robertbraeutigam/cessna172/README.md

# Cessna 172 home cockpit

A home cockpit of the Cessna 172 for the X-Plane flight simulator. The parts
are designed in [OpenSCAD](https://openscad.org/) and 3D printed, and the
controls are read by [MobiFlight](https://www.mobiflight.com/) on an
Arduino Mega (the throttle quadrant uses its own ESP32).

Each cockpit component has its own directory:

| Directory | Component |
|---|---|
| [`throttle/`](throttle) | throttle quadrant: throttle, mixture and carb heat |
| [`switchpanel/`](switchpanel) | the 172N lower left switch panel: ignition key, master, lights, avionics; the primer above it |
| [`frame/`](frame) | the aluminium frame and panel sheet that everything mounts on |
| [`hub/`](hub) | the box with the MobiFlight Mega and the Cat5 ports |

The pictures below are rendered from the current `master` by the
[Build](.github/workflows/build.yml) workflow and published, together with
all printable STLs, on the
[project page](https://robertbraeutigam.github.io/cessna172/).

## Building

The OpenSCAD binary comes from the `OPENSCAD` environment variable; the
designs use OpenSCAD 2021.01. Run `make` in a component directory:

```sh
cd switchpanel
make                       # render every .scad that changed (STLs + views)
make models                # only the STLs
make views                 # only the PNG views
make target/switches       # render a single file
make clean                 # remove target/
```

Output goes to `target/`. Views need a display (use
`OPENSCAD="xvfb-run -a openscad"` on a headless machine) and are trimmed and
combined into a montage if ImageMagick is installed.

A scad file can hold several printable parts. Marker comments on the line
that instantiates a part tell the Makefile what to render:

```openscad
box_lid(); // Make module lid                        -> target/<file>_lid.stl
//#big_pots(); // Ignore module                      -> never rendered
//exploded_view(); // Make view main 62,0,32         -> target/<file>_main.png
```

A leading `//` only hides a line from the OpenSCAD preview; the build still
renders it. `{{gitrev}}` in the source is replaced with the short git hash,
so the version is embossed into the parts.

Values and modules shared by several files of a component go into a
`*.inc.scad` file that the others `include`. It is not rendered itself, and
changing it renders the whole component again.

The printer is an Anycubic Kobra 3 V2 (255 x 255 mm bed). Large parts must
fit on it, and the files check it. Values that depend on bought parts
are marked MEASURE in the source; `assert()`s check that the derived
geometry still fits, so a wrong measurement fails the build instead of
printing a bad part.

# Cockpit frame

[`frame/`](frame): the frame on the desk that carries all components, and
the panel sheet over it.

Cockpit frame

The frame is all 2020 extrusion (one profile, M5 T-nuts everywhere) in two
parts, each built on its own and then bolted together:

- **Front part**, vertical, in front of the desk edge: a rectangle (top
  bar, bottom bar, an upright at each end) with an upright on each side of
  the yoke bay. The bottom bar lies just under the desk top, its top at
  desk height and its back against the desk edge (felt pads), so pushing
  the frame away hits a stop. One
  3 mm aluminium composite (ACM) sheet is screwed onto its front slots.
- **Desk part**, flat on the desk behind it: a ladder of a front rail, a
  rear rail and five crossbars. The front rail is cut at the yoke bay. The
  front part is bolted to the front rail with corner brackets, and a 45
  degree brace from each upright down to a crossbar stops it from rocking.
  The braces are 200 mm stock bars cut square, held by a bought 45 degree
  connector for 2020 at each end, in the obtuse angle (at the top the
  upright has 39 mm above the brace for it; a 250 mm brace would leave
  only 3 mm).

The panel is as low as the parts on it allow: the right stack sets it.
The throttle box face reaches 80 mm above the desk (it stands on the
20 mm rail, 50 mm box and a 10 mm flange), then 20 mm of sheet, the radio
panel's 84 mm front (to 172 mm), 20 mm of sheet and the top bar. The yoke
notch is 135 mm high, for a future 130 mm force feedback yoke (`ffb_h`;
the Saitek yoke is about 100 mm), and the switch panel needs 136 mm. The
build computes the height from these and rounds the uprights up to a
stock length (200 mm), so the panel top is 220 mm above the desk; it
checks that it stays under `sheet_h_max` (260 mm, the monitor).

Seen from the pilot, left to right:

- **Switch panel** (ignition + switches), low on the left.
- **Yoke bay**: the Saitek yoke stands on the desk, 20 mm out so its
  front sits on the bottom bar, its housing in a notch in the sheet. Its
  own clamps go around the bottom bar and the desk (the desk is thicker
  than the bar).
  A future force feedback yoke bolts to a crossbar in the bay instead.
- **Saitek radio panel**, with the **throttle box** under it.

The frame overhangs the desk edge by 22 mm (`frame_overhang`: a 2020 and
a 2 mm felt pad), so the sheet is 22 mm in front of the desk edge; the
front rail lies 18 mm on the desk.

**Desk clamps**: the front rail runs at least 50 mm past the sheet at each
end (`ear_len`, rounded so the rail halves are 450 and 400 mm). There a
bought screw clamp with rubber jaws clamps each
rail end onto the desk (the `clamp` view): the fixed jaw on the rail, the
spine in front of it beside the sheet, the screw jaw on the desk
underside, both jaws where the rail lies on the desk (`clamp_y`, 31 mm
from the frame front). The rail is 20 mm and the desk 28 mm, so a clamp
with a 50 mm opening and at least 33 mm reach fits; the build checks
`clamp_open`, `clamp_reach` and the jaw size. No printed part is in the
load path (printed parts creep under constant load), and two clamps about
1 m apart give well over 2 kN of grip, against 50-100 N of pulling on the
controls.

Below the desk top:

- **Apron**, under the throttle: a small rectangle hanging from the bottom
  bar, two 2020 hangers (corner brackets; the right one under the end
  upright) and a lower bar between their ends, covered by a small ACM
  sheet flush under the main sheet. It carries the **pedestal** with the
  trim wheel and the trim indicator (75 x 150 mm front), centered under
  the throttle, which stands on the lower bar like the throttle box on the
  front rail, and to its right the DIY **flaps panel** (lever pot and
  indicator servo, on hub port 5; not designed yet, so its 50 x 63 mm front
  plate and 64 mm depth are placeholders), as high as the desk allows: its
  body goes through a cut-out in the apron sheet and its plate is screwed
  onto the sheet. The cut-out (`flaps_body`, 3 mm smaller than the plate
  all round) follows the panel once it is designed.
- **Parking brake**, under the bottom bar in the yoke bay, directly below
  the yoke: a thin body (22 mm) under the desk top, two M5 into the bar's
  bottom slot, and the T-handle just in front of the bar. Released, it is
  almost flush and lies sideways; set, it is pulled out 50 mm and turned
  to point down. It has no face. Its body goes between the yoke's own desk
  clamps (`yoke_clamp_gap`).

Apart from the bottom bar and the thin parking brake, `knee_w` (460 mm)
around the yoke stays open for the legs. The pedestal and the parking
brake are future components; their sizes (`pedestal_size`, `park_size`)
reserve the space (the pedestal sets the apron height; its depth and the
parking brake are guesses), and the pedestal's hole is cut when it
exists. Their bodies must stay
below the desk underside.

The rule for every component: it brings its own front face, a hole is cut
into the sheet for it and its face is screwed onto the sheet. Heavy or
pulled components also stand on the frame: the throttle box sits on the
front rail and the crossbar under its middle (its front overhangs the
front part), its face flange is screwed onto the sheet like the switch
panel's and two M5 bolts through its floor go into the front rail.
The pedestal does the same on the apron's lower bar.
The extrusion carries the
loads, the sheet only covers the front, so cut-outs do not weaken it.
Keep at least 25 mm of sheet to the edge and 20 mm between cut-outs, and
drill the corners of a cut-out before sawing it. Holes for future
components are cut when they arrive.

All values are in `frame.inc.scad`; the layout (cut-outs, screw holes) is
computed from the component sizes, and the build prints the cut list
(`echo`). Lengths are rounded to stock lengths: the width to 100 mm
(`round_w`), the other bars to 50 mm (`round_d`). Only the apron's lower
bar (between the leg room and the pedestal, `round_cut`) is cut to an odd
length. With the current guesses the frame is 1000 x 360 mm and 220 mm
high above the desk, the sheet 1000 x 240 mm (it also covers the bottom
bar), the apron sheet
250 x 220 mm. With the ears the frame takes 1143 mm of the desk width.

| Part | 2020 bars |
|---|---|
| front part | top bar 1000, bottom bar 1000, 4 uprights 200, 2 apron hangers 200, lower bar 210 |
| desk part | front rail left 450, front rail right 400, rear rail 1000, 5 crossbars 300, 4 braces 200 (cut square) |

| File | Parts |
|---|---|
| `frame.inc.scad` | extrusion and sheet standard, component sizes, layout, checks |
| `frame.scad` | views, cut list |

**MEASURE:** the desk (`desk`, and `desk_skirt` if it has a frame or
drawer under the top at the front edge), the leg room the pilot needs
(`knee_w`), the desk clamps (`clamp_open`, `clamp_reach`, `clamp_w`,
`clamp_pad_d`), the free width between the yoke's own desk clamps
(`yoke_clamp_gap`), the Saitek yoke housing (`yoke_housing`,
guessed 283 mm wide like the radio panel and about 100 mm high; spec
sheet: 310 mm wide with the wheel), the force feedback yoke's height
(`ffb_h`), the radio panel body that goes through the sheet (`radio_body`,
from Logitech's "Construction dimensions for Flight Panels" drawing) and
the panel height the monitor allows (`sheet_h_max`).

The switch panel's two backs go through one hole, 1 mm larger than the
backs all round; drill its M3 mount holes through the panel's own holes,
with the panels in place. The primer has its own, smaller hole above the
left end of it, 1 mm larger than its square back, and its four flange
holes are drilled the same way. The same goes for the throttle box: its cut-out
is 1 mm larger than the box, open at the bottom, and its
flange holes are drilled with the box in place.

## Hardware

| Qty | Part | Use |
|-----|---|-----|
| 22 | 2020 extrusion, 6 mm slot | front part: top bar, bottom bar, 4 uprights, 2 apron hangers, lower bar; desk part: front rail left and right, rear rail, 5 crossbars, 4 braces (cut square) |
| 8 | 45 degree connector for 2020 | brace ends |
| - | corner brackets, M5 screws, M5 T-nuts | frame joints, and the front part onto the front rail |
| 2 | 3 mm ACM sheet | panel, cut to frame_w x (sheet_h + 20); the apron sheet |
| 43 | M5 button head screw + T-nut | sheets, throttle box, pedestal and parking brake |
| 2 | screw clamp with rubber jaws, 50 mm opening | rail ends onto the desk |
| 3 | felt pad | on the bottom bar's back, against the desk edge |

## Connections

- The **hub** (see [Hub](#hub)) holds the Arduino Mega with the MobiFlight
  firmware and 6 RJ45 ports. A powered USB hub next to it takes the USB
  cables (Mega, throttle ESP32, Saitek yoke, Saitek radio panel, later the
  FFB yoke), so one USB cable runs to the PC.
- Every MobiFlight component connects to its own hub port with one
  straight Cat5 patch cable, soldered straight to the component (see
  [Cables](#cables)): everything inside a component is soldered, the plug
  at the hub is the only separation point.
- There are two kinds of port (see [Port pinout](#port-pinout)): a **mux
  port** for a component with many switches (one CD74HC4067 mux), and a
  **direct port**, whose six signal wires each go to their own Mega pin,
  for servos, encoders, pots and a few switches. Only 5 V and GND are the
  same on both, so one cable carries everything a component like the
  pedestal or the flaps needs.

### MobiFlight

[MobiFlight](https://www.mobiflight.com/) is free and open source (MIT,
[GitHub](https://github.com/MobiFlight/MobiFlight-Connector)). The
MobiFlight Connector runs on the PC (**Windows only**) and talks to X-Plane
11/12 directly through its datarefs and commands (X-Plane's UDP interface,
no plugin). It also flashes the MobiFlight firmware onto the Mega over USB.

In the Connector, the Mega gets one device per thing on a port: a
*Multiplexer* per mux (its SIG pin as the data pin; S0-S3 are set once, on
the first mux, and shared by all), and a *Servo*, an *Encoder*, an *Analog
input* or a *Button* on a Mega pin. Each input (a mux channel is a button)
then sets a dataref or sends a command on press and on release, each output
(servo) follows a dataref. The configuration is a file: keep it with the
cockpit.

MobiFlight sends an X-Plane command only once; it cannot hold one while a
button is pressed (still open:
[MobiFlight-Connector#2405](https://github.com/MobiFlight/MobiFlight-Connector/issues/2405)).
Where a command has to be held, like the ignition START, a small
FlyWithLua (NG) plugin
script in X-Plane does it (see [In X-Plane](#in-x-plane)).

MobiFlight reads encoders only on their own pins, not through a mux, and
drives servos straight from Mega pins, without a second board: that is
what the direct ports are for.

### Port pinout

At the hub it is the RJ45 pin, at the component the wire color (the cable
is soldered there). Pins 4 and 5 (the blue pair) are 5 V and GND on every
port; at the hub they are soldered together across all 6 ports.

**Mux ports (1-3):**

| Pin | T568B color | Signal | At the hub |
|-----|---|---|---|
| 1 | white-orange | S0 | mux bus, Mega pin 22 |
| 2 | orange | S1 | mux bus, Mega pin 23 |
| 3 | white-green | S2 | mux bus, Mega pin 24 |
| 4 | blue | 5 V | all ports, Mega 5 V |
| 5 | white-blue | GND | all ports, Mega GND |
| 6 | green | S3 | mux bus, Mega pin 25 |
| 7 | white-brown | SIG | the port's own Mega pin (the mux output) |
| 8 | brown | AUX | the port's own Mega pin: one analog input, a button or a servo |

S0-S3 are shared by every mux (MobiFlight takes them once per board); at
the hub pins 1, 2, 3 and 6 of ports 1-3 are soldered together (the mux
bus). Every mux gets a pull-up resistor from SIG to 5 V. MobiFlight turns
on the Mega's internal pull-up, but that is weak (20-50 kOhm), and its
docs recommend an extra one for long wires: solder a 4.7 kOhm between the
SIG and VCC pins on each mux board, in the component.

**Direct ports (4-6):**

| Pin | T568B color | Signal | At the hub |
|-----|---|---|---|
| 1 | white-orange | servo 5 V, or line E | servo header 5 V, or its own Mega pin |
| 2 | orange | servo GND, or line F | servo header GND, or its own Mega pin |
| 3 | white-green | line A | its own Mega pin |
| 4 | blue | 5 V | all ports, Mega 5 V |
| 5 | white-blue | GND | all ports, Mega GND |
| 6 | green | line B | its own Mega pin |
| 7 | white-brown | line C | its own Mega pin, or the servo header (servo signal) |
| 8 | brown | line D | its own Mega pin |

Each line is whatever the component needs: a pot wiper (analog Mega
pin), an encoder contact, a switch (any digital pin) or a servo signal.
The rules:

- **A servo** takes its power on the orange pair (pin 1 5 V, pin 2 GND) and
  its signal on pin 7. At the hub they go to the servo header on the
  prototype board (see [Hub wiring](#wiring)), not to the blue pair: the
  servo's current peaks then do not move the GND and 5 V that the pots
  and the logic on the same cable use. Without a servo, pins 1 and 2 are
  two more lines.
- **Pots** go between 5 V and GND of the blue pair, the wiper on a line.
- **Switches and encoders** go to GND (pin 5) like on a mux, active low,
  with a 4.7 kOhm pull-up to 5 V at the component on each line (the same
  reason as the mux SIG pull-up).

**A wrong port does not damage anything**, it only mixes up the inputs in
the sim until the cable is in its own port again (they are numbered). Every
Mega output that goes into a cable has a 330 Ohm resistor in series at the
hub (S0-S3 and each servo signal, on the prototype board), so a component
in the wrong kind of port can not short a Mega output against a switch to
GND or a pot at its end stop. Still, mark the direct ports at the hub (a
paint pen dot next to their numbers).

### Cables

At the hub every cable has its RJ45 plug; at the component it is soldered
straight to the mux or to the parts, without a connector. Cut a patch
cable to length, or in half for two components:

- **Stranded** patch cable, not solid installation cable: solid wire breaks
  next to a solder joint after a few bends.
- **Pure copper** ("CU"), not CCA (copper clad aluminium, common in cheap
  cables): CCA hardly takes solder and breaks easily.
- **Check the colors** against the [Port pinout](#port-pinout) before
  soldering, with a multimeter or a cable tester: most patch cables are
  T568B, a few are T568A (orange and green pairs swapped).
- **Strain relief**: tie the jacket down on the component right before the
  wires fan out (the switch panel has a block for a cable tie next to the
  mux), so pulling the cable never pulls a solder joint. Tin the strands
  first and put heat shrink over every joint; cut unused wires short and
  insulate them.
- Measure the run to the hub and leave some slack: the length is fixed
  once it is soldered.

### Ports

**Mux ports**:

| Port | Component | SIG | AUX |
|---|---|-----|-----|
| 1 | yoke handle: PTT, trim switch, more buttons (FFB yoke, later) | D26 | A1 |
| 2 | free | D27 | A2 |
| 3 | switch panel | D28 | A3, primer |

**Direct ports** (pin 4 5 V and pin 5 GND on all of them):

| Port | Component | Pin 3 (A) | Pin 6 (B) | Pin 7 (C) | Pin 8 (D) | Pins 1, 2 |
|---|---|---|---|---|---|---|
| 4 | pedestal: trim wheel, trim indicator, parking brake | D30, encoder A | D31, encoder B | D2, trim servo | D32, parking brake | servo power |
| 5 | flaps: lever and indicator | A4, lever pot | D33 (free) | D3, flaps servo | D34 (free) | servo power |
| 6 | throttle quadrant (if it moves to the hub, see below) | A5, throttle | A6, mixture | A7, carb heat | A8 (free) | A9, A10 (free) |

The pins are suggestions: any free pin works (pots on analog pins), select
it in the MobiFlight Connector. A component that needs more than a port
gives gets a second port of the kind it needs.

The direct ports leave room: a Mega has 16 analog and 54 digital pins, and
MobiFlight takes at most 6 multiplexers on one (`MaxInputMultiplexer` in its
board file), of which this hub uses 3. More components than the 6 ports get
a second hub with its own Mega, on its own USB cable to the powered USB
hub; the Connector shows it as a second board. Two Megas can not drive the
same S0-S3 bus.

- **Pedestal**: one cable for everything on it. The trim wheel encoder
  (EC11 type, 20 detents) on lines A and B, its common on GND; set the
  encoder type in the Connector to match the encoder (steps per detent) and
  test that a fast spin does not lose steps. The trim indicator servo (9 g)
  on pin 7 and the orange pair.
- **Parking brake**: one switch, on line D of the pedestal port: two wires
  from the pedestal along the bottom bar to the brake under the yoke. A
  *Button* on D32 in the Connector.
- **Flaps** (DIY, on the apron next to the pedestal): the lever pot on
  line A, the indicator servo (9 g) on pin 7 and the orange pair. Two lines
  are left (e.g. a switch at the flap detents, if the lever gets one).
- **Throttle quadrant**: open. It is an ESP32 on USB today; on port 6 its
  three pots go on lines A-C, with no mux and no ESP32.
- **Likely later**: panel light dimmers (pots, on free lines), steam gauges
  (servos on a direct port, or steppers with a driver board in the hub),
  outputs (annunciator lights, avionics displays): MobiFlight drives them
  through 74HC595 shift registers or MAX7219 drivers with three lines each
  (data, clock, latch), which fit a direct port.

**Logic only** on the blue pair: the muxes, pots, encoders and hall
sensors draw a few mA. The servos take their current on their own orange
pair from the servo header in the hub, which is fed from the Mega 5 V for
now (see [Power](#power-later)); put a 470 uF capacitor across the supply
at each servo. A 9 g servo draws about 0.15-0.3 A when it moves and up to
0.7 A stalled, about 0.2 V drop on 2 m of the 24 AWG pair. Two of them on
the Mega's USB 5 V is the limit: if the Mega resets when both move at
once, feed the servo header from a 5 V supply. GND has to stay in the cable
with the signals, and the logic 5 V has to come from the Mega, so a
component is never powered while its inputs are not (or the other way
round).

### Why not a serial bus

A serial bus (I2C, UART, RS485, CAN) would need 2 signal wires instead of
the mux's 5 lines, but it does not save a cable: every component gets one
Cat5 cable either way, with 8 wires, and the S0-S3 lines are shared, so
each extra mux costs only one Mega pin. The options:

- **74HC165 input shift registers**: MobiFlight reads them (*Input Shift
  Register*, 8 inputs per chip, chained). Three lines (data, clock, latch)
  instead of the mux's five, but they also have to go to every component,
  and 8 pull-up resistors per chip: no gain over the mux.
- **I2C port expanders** (MCP23017, PCF8574): not in the standard
  MobiFlight firmware for inputs (it uses I2C only for LCD displays), and
  I2C is made for a circuit board, not for 2 m cables.
- **UART, RS485, CAN**: these need a microcontroller in every component
  and our own firmware at both ends; MobiFlight does not speak them. The
  MobiFlight way to do that is a small board per component that runs
  MobiFlight itself (e.g. an Arduino Pro Micro, on its own USB cable to the
  powered USB hub), like the throttle's ESP32: fine for one or two
  components, but each is one more board to flash and one more USB device.

### Power (later)

USB only for now. With lighting, gauges or the FFB yoke comes one 24 V PSU
with fused branches, buck converters for 5 V, a separate cut-off switch on
the FFB motor power and one star ground at the PSU. The servo header in
the hub is then fed from a 5 V converter instead of the Mega 5 V (remove
its link, see [Hub wiring](#wiring)), so the servos keep their orange pair
in the Cat5. Bigger loads (backlighting, more servos in one component) get
their current from a separate 2 wire 5 V bus with a 2 pin plug per
component (e.g. JST-VH or a 5.08 mm screw terminal), not from the Cat5;
its GND is tied to the Mega GND at one point in the hub. Leave room for
that plug in components with loads; the hub has a hole for the bus in its
back wall.

# Hub

[`hub/`](hub): the box with the MobiFlight Mega and the Cat5 ports.

Hub

`hub.scad` prints the box (`hub_box.stl`, floor down) and the lid
(`hub_lid.stl`, top down). The box is 249 x 135 x 55 mm with the lid
(one row of 6 ports, `port_cols`); the build checks that it fits the
printer bed.

From the front wall to the back:

- **Ports**: 6 RJ45 breakout boards in a row along the front wall,
  their jacks behind cut-outs in it, numbered 1-6 from the left, the
  numbers beside the jacks: 1-3 are the mux ports, 4-6 the direct ports
  (see [Port pinout](#port-pinout); mark them). The boards are screwed onto bosses on the
  floor with M2 self tapping screws from above. Their angled 8 pin headers
  point into the box. Behind them is a 30 mm strip for the jumpers, then one row of
  boards:
- **Mega** (left): on 6 standoffs, its USB jack through the left wall
  (flush with the outside, so any USB-B plug fits), with a cut-out in
  front of the power jack for later.
- **Prototype board** (next to the Mega, 20 mm away): a 50 x 70 mm board
  on four standoffs, with the bus header, the servo header (below) and
  room for small extra circuits if they are needed (later the power bus
  distribution). The hole for the power bus is in the back wall behind it.
  The rest of the row, on the right, stays free (a stepper driver board,
  later).
- The build checks the room for a plugged jumper (30 mm) above every
  board.
- The lid has a locating lip and is screwed onto four corner posts. Four
  ears on the floor (5.3 mm holes) screw the box onto the frame (M5 + T-nut)
  or under the desk.

Nothing on the Mega is soldered: it keeps its pins free and can be reused,
and a port is rewired by moving jumpers. The MobiFlight firmware is flashed
from the Connector through the Mega's USB jack in the left wall, with the
lid on.

### Hardware

| Qty | Part | Use |
|-----|---|-----|
| 1 | Arduino Mega 2560 | MobiFlight board |
| 1 | prototype board, 50 x 70 mm | bus header, servo header, extra circuits if needed |
| 2 | female header strip, 8 pin, 2.54 mm | bus header, servo header |
| 6 | 330 Ohm resistor | in series with S0-S3 and the 2 servo signals |
| 6 | RJ45 breakout board, 34 x 28 mm, angled 8 pin header | the ports |
| 18 | M2 x 6 self tapping screw | RJ45 boards |
| 4 | M2 x 6 screw | prototype board |
| 6 | M3 x 6 self tapping screw | Mega |
| 4 | M3 x 10 self tapping screw | lid |
| - | insulated wire, about 0.25 mm2, 6 colors | the bus |
| ~20 | male-female jumper wire, 20 cm | RJ45 pins to the Mega and to the servo header |
| ~10 | male-male jumper wire, 10 cm | bus and servo header to the Mega |

Per port used: a stranded copper Cat5 patch cable, soldered at the
component end (see [Cables](#cables)).

**MEASURE when they arrive**: the RJ45 boards (`rj_*`): the jack's height
and its position on the board, the header position and the mounting holes
(guessed from the listing picture; fix `rj_holes` before printing, the
build checks that the bosses stay on the board). The
prototype board's hole positions (`proto_*`; if its holes are smaller than
M2, use M1.6 screws). The Mega values are from the Arduino drawing.

### Wiring

**Bus**: one insulated wire per line, one color each, soldered along the
row of boards. Strip a short piece of insulation where it passes a pin and
solder it there, at the pin's base by the header, so it does not touch the
other pins it crosses:

- 5 V and GND (pins 4 and 5): across all 6 ports.
- S0, S1, S2, S3 (pins 1, 2, 3 and 6): across the mux ports 1-3 only.
  Ports 4-6 keep these pins for their own lines.
- To the prototype board: six wires from port 1's pins 1-6 to an 8 pin
  female header on it (the bus header): S0, S1, S2, S3, 5 V, GND, 5 V,
  GND. S0-S3 go through a 330 Ohm resistor each, soldered between the
  wire and the header pin.

**Servo header**: a second 8 pin female header on the prototype board,
for the servos of ports 4 and 5: 5 V, GND, signal in, signal out, twice.
Each signal in goes through a 330 Ohm resistor to its signal out. Its 5 V
pins are joined to the bus header 5 V by one wire link (the one to remove
when a 5 V supply feeds the servos, see [Power](#power-later)), its GND
pins to the bus header GND for good.

Everything else is a jumper:

| From | To | Jumper |
|---|----|---|
| ports 1-3 pin 7 (SIG) and pin 8 (AUX) | their Mega pins (see [Ports](#ports)) | male-female |
| ports 4-6, each pin with a line | its Mega pin | male-female |
| ports 4 and 5 pins 1, 2, 7 (servo 5 V, GND, signal) | servo header 5 V, GND, signal in | male-female |
| servo header signal out | Mega D2 (port 4), D3 (port 5) | male-male |
| bus header S0-S3 | Mega pins 22-25 | male-male |
| bus header 5 V, GND | Mega 5 V, GND | male-male |

Add a Servo device on D2 and D3 in the Connector.

### Assembly

1. Screw the RJ45 boards onto their bosses (M2 x 6).
2. Solder the bus wires along the row (S0-S3 only across ports 1-3).
3. Solder the bus header, the servo header and the resistors onto the
   prototype board and wire the bus header to port 1.
4. Screw the prototype board and the Mega onto their standoffs.
5. Plug the jumpers as above and label them.
6. Screw the lid on.

# Throttle quadrant

[`throttle/`](throttle): throttle, mixture and carb heat in one box.

Throttle quadrant

Each control is a 6 mm rod that comes out of the front of the box and moves
the slider of a linear potentiometer inside: long pots (130 mm) for the
throttle and mixture, a short one (75 mm) for the carb heat. The pots sit on
stands and are held down by printed pins. A printed clamp on each rod has a
slot that takes the pot's slider ear, so pulling the knob moves the slider.
An ESP32 on a pedestal at the back reads them and connects to the simulator
over USB.

The box mounts in the [cockpit frame](#cockpit-frame) and has no lid: it
goes through a cut-out in the panel sheet and stands on the frame's front rail. Its
front wall is the face, with a 10 mm flange on the top and the two sides
(none at the bottom, where the box sits on the rail) that is screwed onto
the sheet with M3 screws, nuts behind the sheet. Two M5 bolts through the
floor, at the front between the rod supports, go into T-nuts in the
front rail's top slot, so pulling a knob does not load the sheet alone.

| File | Parts |
|---|---|
| `throttle_box.scad` | the box with its face flange (printed in one piece), pot holder, cable cradle |
| `carb_heat_knob.scad` | carb heat knob and button |
| `clamp.scad` | rod clamps for the pot sliders |
| `pin.scad` | pot hold-down pins |

## Hardware

| Qty | Part | Use |
|-----|---|-----|
| 2 | linear potentiometer, 130 mm | throttle, mixture |
| 1 | linear potentiometer, 75 mm | carb heat |
| 3 | 6 mm rod, with nuts | one per control |
| 1 | ESP32 board | reads the pots, USB to the PC |
| - | M3 screws | pot hold-downs, cable cradle |
| 5 | M3 x 10 pan head screw + nut | face flange onto the cockpit sheet |
| 2 | M5 x 10 button head screw + washer + T-nut | floor into the front rail (counted in the frame) |

# Switch panel

[`switchpanel/`](switchpanel): the lower left switch panel of the 172N.
Similar in function to the Saitek Switch Panel, but it should look as close
to the real panel as possible. Every switch position is a raw input for
MobiFlight, active low, like a switch to GND.

It is two panels, printed separately and mounted side by side: the ignition
on the left and the switch row, which also carries the input multiplexer
for both. Their basics are in `panel.inc.scad`: both are 3 mm thick,
with the same rim, flange, mount holes and lettering. The back of each
panel is 80 mm high (`panel_h`), closed by an 8 mm rim, and goes through a
hole in the cockpit sheet ([frame](#cockpit-frame)); a 10 mm face flange
(`flange_w`) on the top, the bottom and the outer end sits on the sheet
and is screwed to it with M3 screws, nuts behind the sheet. Where the two
panels meet there is no flange and the corners are square, so together
they look like the one piece panel of the airplane (about 309 x 100 mm,
the face 3 mm in front of the sheet).

The [primer](#primer) is a third, small panel of its own above the left
end (`primer.scad`), with its own hole in the sheet. `panel.inc.scad`
takes the height of the back as a parameter for it.

## Ignition switch

Ignition switch

`ignition.scad`: the OFF - R - L - BOTH - START key switch. The key turns
clockwise; OFF, R, L and BOTH are detents, START is spring loaded and
returns to BOTH.

### How it works

It is built around a cheap mailbox (cabinet) cam lock. These locks turn
only 90°, so the lock is made to turn freely and the assembly has its own
end stops for the whole OFF..START sweep. On the lock used here the stop is
a small tab (about 1 mm) on the plug just behind the face, which runs into
two of the four grooves in the housing: take the cam, its washer and the
cam screw off, pull the plug out with the key in (the small detent ball
falls out, it is not needed), file the tab flush with the plug and put it
back; the printed rotor on the spindle then holds the plug in. The key can
be pulled every 90°, with the key parallel or perpendicular to the body
flats (`lock_key_home`), so the flats of the cutouts in the face, panel
and housing are turned to put one of these positions at OFF. It also
comes out 90° further, at BOTH.

A printed rotor on the lock's spindle sits in a housing behind the panel,
closed by a cover:

- **Detents:** a steel ball, pushed by a spring in a radial channel of the
  housing, drops into notches in the rotor rim. START has no notch.
- **End stops:** a lug on the rotor rim moves in a pocket of the housing.
- **START return:** an M3 screw through the cover is a pin in an arc slot of
  the rotor. From OFF to BOTH it moves freely in the narrow part of the
  slot. Past BOTH it pushes a printed shoe that compresses a spring in the
  wide part, and the spring pushes the key back to BOTH.
- **Sensing:** a magnet in the rotor lug and one digital hall sensor per
  position in the cover. The sensors (A3144, unipolar, not latching) are
  open collector and pull low over the magnet, so each one is wired like a
  switch to GND. They are glued into pockets on the inside of the cover,
  marked face towards the rotor, and their legs are bent 90° backwards
  through slots in the cover.
- **Sensor boards:** the wires are not soldered to the thin legs but to a
  small piece of prototype board on each sensor (3 x 4 holes, 2.54 mm
  pitch). It slips onto the legs about 5 mm behind the cover
  (`board_z`), where they have spread to 2.54 mm. A printed holder, an
  arc on the back of the cover, has a post under each board, and one M2
  screw through a hole drilled in the board's outer row holds it there.
  The hole is in the OUT leg's column (the A3144 legs are 5 V, GND, OUT
  seen on the marked face), which needs only one wire, so the 5 V and GND
  columns keep two free holes each: one for the wire in, one for the wire
  on to the next board.
  The holder's two ears go under the two cover screws on the switch panel
  side and are clamped by the cap. A 3 x 5 piece works too, with the legs
  in its second row (`board_rows = 5`, `board_leg_row = 1`).
- **Back cap:** a cap over the cover protects the boards, their solder
  joints and the wires. The 7 wires (5 signals, 5 V, GND) leave through a
  notch in its wall towards the switch panel; hot glue in the notch is the
  strain relief, so pulling the cable does not pull on the legs. The cover
  screws go through the cap as well.

Printed parts: face, panel, housing, rotor, shoe, cover, holder, cap.

The panel is 87 x 100 mm (the back 77 x 80 mm). Its front is a separate
1 mm face with the position labels, tick marks and MAGNETOS standing 0.8 mm
out of it around the key, to be painted with a white acrylic paint pen.
The face is printed front side up (the STL is already flipped), the panel
front side down, so neither needs supports; together they are 3 mm thick,
like the switch panel. The mount screws clamp the face onto the panel,
and so does the lock flange (glue or double sided tape it on
as well if it bows); it has holes around the heads of the panel screws.
The lock body goes through
a cutout with flats, so it cannot turn, and the housing sits on the back,
between the rims. The cutout is turned so the key points at OFF
(`key_off_angle`) where it comes out of the lock.

### Hardware

| Qty | Part | Use |
|-----|---|-----|
| 1 | mailbox / cabinet cam lock | key and spindle (`lock_*`: 18 mm thread, 17 mm body, 25 x 4 mm nut, 7 mm square spindle, its M4 x 5 cam screw with a 12 mm head holds the rotor) |
| 1 | 6 mm steel ball + spring | detent (`detent_spring_*`, spring OD below 6 mm) |
| 1 | spring, 5 mm OD, 15 mm | START return (`start_spring_*`) |
| 1 | cube magnet, 5 x 5 x 5 mm | position sensing (`magnet_*`) |
| 5 | A3144 hall sensor | one per position (OFF is optional) |
| 1 | prototype board, 2.54 mm pitch | 5 pieces of 3 x 4 holes, one on each sensor's legs |
| 5 | M2 x 6 screw | sensor boards onto the holder |
| 4 | M3 x 25 screw | cap and cover (M3 x 10 to test without the cap) |
| 4 | M3 x 10 screw | panel to housing |
| 1 | M3 x 8 screw | START pin |
| 4 | M3 x 10 pan head screw + nut | panel onto the cockpit sheet |

### Assembly

1. Put the lock through the panel and the housing, screw the panel to the
   housing, tighten the lock nut.
2. Mount the rotor with the lock's cam screw.
3. Insert the ball and its spring, and the shoe and its spring.
4. Check which magnet face triggers the sensors, then glue in the magnet and
   the sensors.
5. Screw on the cover (M3 x 10 screws to test), then put in the START pin.
6. Drill the outer row hole in the OUT leg's column of each board piece
   to 2.2 mm.
   Put the holder on the cover (ears over the two cover screw holes on the
   switch panel side), slip the boards onto the sensor legs and screw them
   onto the posts with the M2 screws.
7. Solder the legs to the boards and trim them. Solder the wires into the
   next row, each next to its leg, and bridge them to it: 5 V and GND
   chained from board to board, one signal wire each.
8. Lay the bundle into the cap's notch, screw on the cap with the M3 x 25
   screws (it clamps the holder's ears), and fill the notch with hot glue,
   with a blob on the inside that is bigger than the notch.

The positions (30° apart) should be verified against the real switch.

### In X-Plane

X-Plane's key is spring loaded: writing START (4) to
`sim/cockpit2/engine/actuators/ignition_key` jumps back to BOTH in the next
frame, and MobiFlight cannot hold the starter command. So START goes
through `switchpanel/ignition.lua`, a FlyWithLua script: it creates the
dataref `cessna172/ignition/start` and holds `sim/starters/engage_starter_1`
while it is 1. Copy it to `X-Plane/Resources/plugins/FlyWithLua/Scripts/`.

In the MobiFlight Connector (inputs C11..C15 of the mux):

| Input | On press | On release |
|---|---|---|
| OFF, R, L, BOTH | `sim/cockpit2/engine/actuators/ignition_key[0]` = the position | nothing |
| START | `cessna172/ignition/start` = 1 | `cessna172/ignition/start` = 0 |

Releasing START springs the key back to BOTH, whose sensor sets the key
position again. **VERIFY** the key values (0 is OFF, 3 is BOTH; check
which of 1 and 2 is L) with DataRefTool while turning the key in the
virtual cockpit. Start X-Plane (or reload the Lua scripts) before
connecting MobiFlight, the START dataref only exists once the script has
run. If MobiFlight disconnects in START, the starter keeps cranking until
the key is turned in the cockpit or the scripts are reloaded.

## Primer

Primer

`primer.scad`: the push-pull primer with its twist lock, read by a linear
pot. It is a separate 47 x 47 mm panel above the left end of the switch
panels, flush with their left edge, in its own cut-out in the sheet, so
the ignition panel stays as it is. The knob pulls out 45 mm (`stroke`,
about the 1¾" of a panel plunger primer) and pushes back in; fully in, it
turns a quarter turn clockwise to lock, and only then. Turned back
(counterclockwise), a spring pops it 5 mm out (`pop`), like the real one.

### How it works

The same idea as the [throttle quadrant](#throttle-quadrant): a 6 mm rod
moves the slider of a linear pot, through a clamp-like carrier with a slot
over the pot's slider ear. The pot is the 75 mm one used for the carb heat.

- **Knob and twist lock:** the knob's 10 mm stem slides in a square tube on
  the back of the panel, the front bearing. A lug on the end of the stem
  runs in a keyway along the tube, so the knob cannot turn while it is out
  and always comes back lined up. At the back of the tube the keyway opens
  into a quarter turn pocket: fully in, the lug turns into it and the end of
  the keyway holds it (locked). Pulled out, the lug stops on the back of
  the panel plate.
- **Rod:** an M3 set screw in the knob's head holds the rod. The rod runs
  back through the bracket, whose front wall (screwed onto the end of the
  tube) and rear wall are two more bearings.
- **Pot:** in the bracket the pot sits on two stands, held down by two
  printed straps, with its slider ear pointing at the rod. The carrier on
  the rod is held between two rod collars (the throttle's plain clamp). The
  rod turns in it for the twist lock; the carrier itself slides between the
  bracket's two ribs, so it cannot turn.
- **Pop out:** a compression spring on the rod, between the rear collar and
  the rear wall. The collar only reaches it in the last 5 mm before the knob
  is in, so the locked lug holds it compressed, and unlocking pops the knob
  out that far; the rest of the stroke is free.

The bracket is beside the rod towards the pilot's right, about 41 x 26 mm
across, and with the knob in, the rod ends about 193 mm behind the panel,
over the switch panel and clear of the frame's upright and brace. The
bracket is wider than the cut-out, so it goes on from behind the sheet.

### Hardware

| Qty | Part | Use |
|-----|---|-----|
| 1 | linear potentiometer, 75 mm (like the carb heat one) | primer position |
| 1 | 6 mm rod, 208 mm (`rod_len`) | knob to the pot carrier |
| 1 | compression spring, about 9 mm OD, 6.8 mm ID, 15 mm long (`pop_spring_*`) | pops the knob out when unlocked |
| 2 | `throttle/clamp.scad` plain clamp (`clamp_plain.stl`), with an M3 screw + nut | rod collars on both sides of the carrier |
| 4 | M3 x 12 socket head screw | bracket onto the tube |
| 4 | M3 x 10 screw | pot straps onto the stands |
| 1 | M3 x 6 set screw | knob onto the rod |
| 4 | M3 x 10 pan head screw + nut | face flange onto the sheet |
| - | 3 wires | pot to the switch panel's mux board |

Printed: `primer_panel.stl` (front side down), `primer_face.stl` (front
side up), `primer_knob.stl` (on the end of its stem), `primer_bracket.stl`
(on its spine), `primer_strap.stl` (2x), `primer_carrier.stl`.

The pot's travel (`pot_travel`) is measured: 60 mm, so the 45 mm stroke
uses the middle three quarters of it (the build fails if the stroke comes
within 4 mm of the travel). **MEASURE:** the pot's slider ear (`pot_ear`)
and the spring you pick (`pop_spring_od`, `_id`, `_len`, `_solid`): it
has to fit over the rod and on the collar, and it must not go solid
before the knob is in; the bracket gets longer for a longer spring. A
stiffer spring pops harder, the pot slider's friction works against it.

### Assembly

1. Paint the label, put the face on the panel, push the panel through its
   cut-out and screw the flange onto the sheet.
2. From behind: put the knob's stem into the tube, the lug in the keyway.
3. Screw the bracket onto the end of the tube (hex key through the holes
   in its rear wall).
4. Solder three wires to the pot, put it onto its stands and screw the
   straps on.
5. Push the rod in from the back: through the rear wall, the spring, a collar, the
   carrier (its slot over the pot's ear), the other collar, the front wall
   and into the knob, and tighten the set screw.
6. With the knob out, slide the carrier to where the ear is 22.5 mm
   (`stroke / 2`) in front of the pot's middle, and tighten the collars
   against it so the rod still turns.

### Wiring and X-Plane

The pot connects to the switch panel's mux board: its ends to 5 V and GND
there, the wiper to the brown AUX wire of the Cat5 cable, which goes to
the Mega's A3 at the hub (port 3, see [Ports](#ports)). It is an analog
input, not a mux input. Which end goes to 5 V decides the direction; swap
them, or invert the range in the MobiFlight Connector.

In the MobiFlight Connector it is an analog input on A3 that writes the
primer's dataref. **VERIFY** which dataref the X-Plane 172 uses for the
primer with DataRefTool while working the primer in the virtual cockpit.

## Switches

Switch panel

`switches.scad`: the switch row. The red split MASTER (ALT, BAT) on the
left, toggle switches in the middle (FUEL PUMP, BEACON, LAND, TAXI, NAV,
STROBE, PITOT HEAT) and the split AVIONICS (BUS 1, BUS 2) on the right.
Up is ON, like in the airplane. Above the toggles is a
row of circuit breakers, like on the real panel; they are for show only.

The switch list (`groups` in the source) drives the layout; it follows the
X-Plane 172 SP. For a 172N remove FUEL PUMP and the panel gets shorter. The
panel is 221.6 x 100 mm (the back 211.6 x 80 mm). Like the ignition, its
front is a separate 1 mm face with the labels standing 0.8 mm out of it,
for a white paint pen; the face is printed front side up
(`switches_face.stl`), the panel front side down, so neither needs
supports, and together they are 3 mm thick. The toggle nuts, the rocker
lips and the mount screws clamp the face on. The switches and labels need about 68 mm of the back's height, the
rest is split between above and below them. The rim on the back stiffens
it.

### Hardware

| Qty | Part | Use |
|-----|---|-----|
| 1 | double rocker switch, 6 pin, red | MASTER: ALT, BAT |
| 1 | double rocker switch, 6 pin, black (there is no white one) | AVIONICS: BUS 1, BUS 2 |
| 7 | toggle switch, M12 neck, 18 mm lever | FUEL PUMP, BEACON, LAND, TAXI, NAV, STROBE, PITOT HEAT |
| 6 | M3 x 10 pan head screw + nut | panel onto the cockpit sheet (`mount_count`) |
| 1 | CD74HC4067 16 channel mux breakout board | all inputs, see [Multiplexer](#multiplexer) |
| 2 | M2 x 6 screw | mux onto its standoffs |
| 7 | printed dummy breaker (`switches_breakers.stl`) + glue | circuit breakers, see [Circuit breakers](#circuit-breakers) |
| 1 | 4.7 kOhm resistor | SIG pull-up on the mux |
| 1 | Cat5 patch cable, stranded copper (see [Cables](#cables)) | to hub port 3, soldered to the mux |
| 1 | cable tie, up to 3.6 mm wide | the cable onto its block (`tie`) |
| - | wire, heat shrink | see [Wiring](#wiring) |

### Double rocker switches

[Double Rocker Switch 6-Pin 250V 16A/AC Red Rocker Illuminated On/Off](https://www.amazon.de/-/en/Double-Rocker-Switch-6-Pin-Illuminated/dp/B0DLTMGKSS),
in red for MASTER and black for AVIONICS. Two independent rockers side by
side in one housing, tall and narrow like the real split switches.

They snap into a cutout from the front: ramps on their top and bottom end
catch behind the face and the panel, which is thinned there by a pocket
in the back, to 0.5 mm behind the 1 mm face.
Dimensions from the listing (`rk_*`):

- panel cutout 22 x 28.5 mm (width x height)
- front lip 24.3 x 31.3 mm, 2 mm thick
- body 21.7 x 25.3 mm, no mounting holes
- 31.5 mm from the front to the end of the pins

**MEASURE when they arrive:** the gap between the lip and the ramps, i.e.
the panel thickness they snap onto (`rk_grip`, now 1.5 mm). Also check the
pin positions.

The lamps are neon (250 V) and will not light on 5 V; leave the lamp pin
unconnected. Each rocker has 3 pins: find the two that close when the
rocker is ON with a multimeter.

### Toggle switches

Standard M12 toggle switches, about the size of the real ones. From the
listing: body 30 x 15.5 x 15 mm, 12 mm neck (M12 thread), 18 mm lever.
Either a 2 pin ON-OFF or a 6 pin ON-ON (DPDT) switch works. Do not take an
ON-OFF-ON one (e.g. "-203"): the real switch has no center position.

The toggles go in from the back, and a nut and washer on the front clamp
them. The body sits in a 1 mm deep square pocket in the back of the panel,
so it cannot turn.

**MEASURE when they arrive** (`tg_*`, `toggle = "M12"`):

- The 30 mm is assumed to be from the top of the body to the end of the
  lugs, and 15.5 x 15 mm the body.
- The thread length (now 9.5 mm; the panel is 2 mm thick there, the washer
  and nut need about 4 mm of it).
- The nut across flats (now 14 mm). The switches are 19 mm apart, so a nut
  up to about 15 mm fits; the build checks this.
- The lever and the lug positions.

The mini MTS-202 (M6, 10 mm lever) works too: set `toggle = "MTS-202"`.
amazon.de listings:
[ETOPARS, 10 pieces](https://www.amazon.de/ETOPARS-Kippschalter-Armaturenbrett-Wippschalter-L%C3%B6tanschluss/dp/B08Z7R4RB9),
[Taiss, 10 pieces](https://www.amazon.de/MTS-202-Terminals-Positionen-Kippschalter-wasserdichte/dp/B07JNV6SCJ).

### Circuit breakers

The real 172N has a row of push-to-reset circuit breakers above the
switches, each with its name on the panel above it and its rating (A) on
the button. Here they are non-functional dummies: a hex nut with a button
on top and the rating engraved into the button, all printed as one part
(`switches_breakers.stl`, nut side down). They are glued into hex holes in
the 1 mm face, onto the panel behind it, which locate them and keep them
straight; nothing goes through the panel. Print them in black and paint the
nut silver and the rating white, or print the nut and the button in
different colors.

The list (`breakers` in the source, name and rating) is placed over the
toggles, one above each, from the left; the build checks that the row
still fits the panel height, and the top middle mount screw moves between
two breakers. Real breakers
(e.g. Klixon push-to-reset) would need a bigger hole and room behind the
panel, so making them functional later means a hole through the panel
as well.

### Multiplexer

All switches and the ignition go to one CD74HC4067 breakout board on the
back of the switch panel. MobiFlight reads it as a Multiplexer device: 16
inputs through one Mega pin. So everything is soldered on the panels, and
only one Cat5 cable runs to the hub (port 3).

The board sits on two standoffs in the strip behind the group labels, on
the left (pilot side) half, where the ignition cable comes in. Mount it with
the chip outwards, so the solder joints face you; `assert`s check that it
clears the switches and fits inside the rim.

**MEASURE when it arrives** (`mux_*`): the board is 40 x 18 mm in the
listings (one says 41 x 18.7 mm). The mounting holes (`mux_holes`, guessed
on the center line 17.5 mm from the middle) and the order of the control
pins (`mux_ctl_names`) are guesses. If the board turns out bigger the build
fails; then increase `margin_top`. If it has no mounting holes, glue it onto
the standoffs.

#### Inputs

| Mux | Input | Mux | Input |
|-----|---|-----|---|
| C0 | MASTER ALT | C8 | PITOT HEAT |
| C1 | MASTER BAT | C9 | AVIONICS BUS 1 |
| C2 | FUEL PUMP | C10 | AVIONICS BUS 2 |
| C3 | BEACON | C11 | ignition OFF |
| C4 | LAND | C12 | ignition R |
| C5 | TAXI | C13 | ignition L |
| C6 | NAV | C14 | ignition BOTH |
| C7 | STROBE | C15 | ignition START |

That is all 16. The switches are in label order (the `groups` order), and
the ignition positions are consecutive. In the MobiFlight Connector every
channel is a button: a toggle or rocker sets its dataref to 1 on press and
to 0 on release, an ignition position sets the key position on press, and
START holds the starter while it is pressed through a FlyWithLua script
(see [In X-Plane](#in-x-plane)). Without FUEL PUMP (172N) or
the OFF hall sensor, one input stays free.

#### Cable to the hub

The mux goes to hub port 3 (see [Port pinout](#port-pinout)) with a Cat5
cable soldered straight into its control row (see [Cables](#cables)):

| Mux pin | Wire (T568B) | Mega (at the hub) |
|---|---|---|
| S0, S1, S2, S3 | white-orange, orange, white-green, green | pins 22, 23, 24, 25 (shared by all muxes) |
| VCC | blue | 5 V |
| GND | white-blue | GND |
| SIG | white-brown | D28, the mux's data pin in the MobiFlight Connector |
| EN | - | not to the hub: bridge it to GND on the board (enable is active low) |

The brown wire (AUX) is the [primer](#primer) pot's wiper; the pot's
other two wires go to VCC and GND on the board. The cable
comes in over the top rim and is tied down with a cable tie on the block
right of the mux (`tie_block`: the tie goes through the slot at the panel
and around the cable in the groove on top), so the wires fan out from
there to the pins without any pull on them. **MEASURE** the cable
(`cable_d`, 6 mm) and the tie (`tie`, 3.6 x 1.3 mm).

The switches and the hall sensors have no pull-up resistors of their own:
one 4.7 kOhm resistor from SIG to VCC on the mux board pulls whichever
input is selected up (see [Port pinout](#port-pinout)). Test it on
the bench with one switch on the mux before soldering all of them.

### Wiring

Every input is wired like a switch to GND (active low, as MobiFlight expects):

- **Toggle, 2 pin:** one lug to GND, the other to its mux input. Mount it so
  it is ON with the lever up.
- **Toggle, 6 pin:** use one pole. Its middle lug (common) goes to GND, the
  bottom lug to the mux input: lever up (ON) connects the common to the
  bottom lug. Check with a multimeter.
- **Rocker:** the two pins of each rocker that close when it is ON; one to
  GND, the other to the mux input.
- **Ignition:** the A3144 outputs go to C11..C15. The sensors also need 5 V
  and GND: take them from the mux VCC and GND.
- **Primer:** the pot's ends to the mux VCC and GND, its wiper to the Cat5
  cable's brown AUX wire (not to the mux).

So on the switch panel: one GND wire daisy chained over all 11 switches to
the mux GND, and one signal wire from each switch to its C pin, soldered
straight into the board. The ignition cable (5 signals, 5 V, GND) is best
plugged in with a 7 pin Dupont or JST connector, so the two panels can be
separated. GND and VCC get several wires (switch chain, EN bridge,
ignition, primer, Cat5 cable): join the extra wires into one before the pin, with
solder and heat shrink.

### Assembly

1. Solder the wires to the switches first; the rockers are hard to get out
   again once snapped in.
2. Lay the face on the front, put the toggles in from the back and
   tighten their nuts.
3. Snap the rockers in from the front.
4. Solder the other wire ends to the mux and screw it onto its standoffs.
5. Solder the Cat5 cable to the mux control row and tie it onto its
   block.
6. Glue the dummy breakers into their pockets.
7. Mount the panel.

### Notes

- ALT and BAT are two independent switches. The real split master has an
  interlock (ALT pushes BAT on, BAT pushes ALT off); X-Plane does not need
  it.
