robertbraeutigam/cessna172/frame/frame.scad

// Cockpit frame
//
// Two parts of 2020 extrusion: the front part (a vertical rectangle with
// the uprights, in front of the desk edge, and the apron hanging under the
// throttle) and the desk part (a ladder on the desk, cut at the yoke),
// bolted together and braced at 45 degrees; one ACM sheet over the front
// with a cut-out for every component. Values, layout and checks are in
// frame.inc.scad; this file has the views and the cut list (echo). It has
// no printed parts.
//
// Bought parts (lengths: see the echo of the build, or the README):
// - 2020 extrusion, front part: top bar, bottom bar, 4 uprights,
//   2 apron hangers, lower bar
// - 2020 extrusion, desk part: front rail left, front rail right, rear
//   rail, 5 crossbars, 4 braces (cut square)
// - 8 45 degree connectors for 2020, one at each brace end
// - corner brackets, M5 screws and T-nuts (6 mm slot)
// - 3 mm ACM sheet, frame_w x (sheet_h + ext), and the apron sheet
// - 2 screw clamps with rubber jaws, at least ext + desk.z opening
//   (clamp_open, clamp_reach), to clamp the rail ends onto the desk
// - felt pads on the bottom bar's back, against the desk edge
//
// Assembly:
// 1. Front part, flat on the floor: the bottom bar, the uprights on it,
//    the top bar on them, the two hangers under the bottom bar and the lower
//    bar between their ends, all with corner brackets.
// 2. Cut the sheets (cuts, sheet_screws, apron_screws in the echo, the
//    "sheet" view), drill their screw holes, and screw them onto the front
//    slots with T-nuts.
// 3. Desk part: the front rail halves, the rear rail and the crossbars.
// 4. Put the desk part on the desk, stand the front part in front of the
//    desk edge, its bottom bar against the edge (felt pads), and bolt it
//    on: a corner bracket from each upright's back to the front rail, the
//    braces from the uprights to the crossbars with a 45 degree connector
//    on each end, in the obtuse angle. Clamp each rail end (ear) onto
//    the desk with a screw clamp. Put the yoke into the bay, its front on the bottom bar, and
//    clamp it with its own clamps.
// 5. Push the throttle box through its cut-out onto the rail and the
//    middle crossbar until its face is on the sheet, bolt its floor into
//    the rail (throttle_bolts), drill the sheet through
//    its flange holes and screw the flange on (M3, nuts behind the sheet).
//    The pedestal goes in the same way onto the lower bar, the parking
//    brake under the bottom bar, when they exist.

include <frame.inc.scad>

$fn = 40;

// --- View colors ---
c_alu = "#c3c9d0";
c_sheet = "#4a4f57";
c_desk = "#c8a77a";
c_device = "#2b2e33";
c_display = "#c0392b";
c_box = "#5b6f8a";
c_switch = "#3a3d42";

echo(frame = [frame_w, frame_d, sheet_h]);
echo(front_part_2020 = [["top bar", frame_w], ["bottom bar", frame_w], ["4 uprights", upright_len],
                        ["2 hangers", hanger_len],
                        ["lower bar", apron_bar_len]]);
echo(desk_part_2020 = [["front rail left", rails[0][1] - rails[0][0]], ["front rail right", rails[1][1] - rails[1][0]],
                       ["rear rail", frame_w], ["5 crossbars", crossbar_len], ["4 braces, cut square", brace_len]]);
echo(sheet = [frame_w, sheet_h + ext], screws = len(sheet_screws));
echo(switch_cut = switch_cut, bay_cut = bay_cut, throttle_cut = throttle_cut, radio_cut = radio_cut,
     primer_cut = primer_cut);
echo(sheet_screws = sheet_screws, throttle_bolts = throttle_bolts);
echo(apron_sheet = [apron[1] - apron[0], apron_h - ext], apron_screws = len(apron_screws));
echo(pedestal_cut = pedestal_cut, pedestal_bolts = pedestal_bolts, flaps_cut = flaps_cut);
echo(m5 = len(sheet_screws) + len(apron_screws) + 2 + 2 + 2, desk_clamps = len(clamp_xs), clamp_y = clamp_y);

// --- Frame ---

module bar(p0, size) {
   color(c_alu) translate(p0) cube(size);
}

// 45 degree brace behind the upright at x, cut square: its inner edge
// from the upright's back at brace_top down to the crossbar top, and a 45
// degree connector in the obtuse angle at each end (drawn on its +x side)
module brace(x) {
   a = [ext, brace_top];
   d = [1, -1] / sqrt(2);       // along the brace (y, z)
   o = [1, 1] / sqrt(2);        // away from the corner
   multmatrix([[1, 0, 0, x], [0, d.x, o.x, a.x], [0, d.y, o.y, a.y], [0, 0, 0, 1]])
      color(c_alu) cube([ext, brace_len, ext]);
   // connectors (view only): one leg on the brace, one on the upright / crossbar
   color("#5a6068") translate([x + ext, 0, 0]) rotate([0, 90, 0]) linear_extrude(3)
      for (e = [[a, [0, 1], d], [a + brace_len * d, [1, 0], -d]])
         hull() {
            translate([-(e[0].y + 2), e[0].x + 2]) square(1);
            translate([-(e[0].y + 2 + 30 * e[1].y), e[0].x + 2 + 30 * e[1].x]) square(1);
            translate([-(e[0].y + 2 + 30 * e[2].y), e[0].x + 2 + 30 * e[2].x]) square(1);
         }
}

module front_part() {
   bar([0, 0, sheet_h - ext], [frame_w, ext, ext]);
   bar([0, 0, -ext], [frame_w, ext, ext]);
   for (x = upright_xs)
      bar([x, 0, 0], [ext, ext, upright_len]);
   // apron
   for (x = hangers)
      bar([x, 0, -ext - hanger_len], [ext, ext, hanger_len]);
   bar([apron_bar[0], 0, -apron_h], [apron_bar_len, ext, ext]);
}

module desk_frame_part() {
   for (r = rails)
      bar([r[0], ext, 0], [r[1] - r[0], ext, ext]);
   bar([0, rear_y, 0], [frame_w, ext, ext]);
   for (x = crossbar_xs)
      bar([x, 2 * ext, 0], [ext, crossbar_len, ext]);
   for (x = upright_xs)
      brace(x);
}

module frame_part() {
   front_part();
   desk_frame_part();
}

// Bought screw clamp, view only: the fixed jaw on the rail end, the spine
// in front of the rail, the screw jaw on the desk underside
module desk_clamp_part(x) {
   bar_w = 12;                                // the clamp's bars, across (x) and thick
   spine_y = clamp_y - clamp_reach;           // spine inner face
   top = ext + 3;                             // over the rubber jaw
   low = ext + 3 - clamp_open - 12;        // bottom bar top, the opening left as screw travel
   translate([x, 0, 0]) {
      color("#5a6068") {
         translate([-bar_w / 2, spine_y - bar_w, low - bar_w]) cube([bar_w, bar_w, top + bar_w - low + bar_w]);
         translate([-bar_w / 2, spine_y - bar_w, top]) cube([bar_w, clamp_reach + bar_w + clamp_pad_d / 2, bar_w]);
         translate([-bar_w / 2, spine_y - bar_w, low - bar_w]) cube([bar_w, clamp_reach + bar_w + 8, bar_w]);
      }
      color("#b9c0c8") translate([0, clamp_y, low - bar_w - 25]) {
         cylinder(d = 8, h = -desk.z - 6 - (low - bar_w - 25));
         translate([0, 0, 6]) rotate([0, 90, 0]) cylinder(d = 7, h = clamp_w + 15, center = true);
         translate([0, 0, -desk.z - 6 - (low - bar_w - 25)]) cylinder(d = clamp_pad_d, h = 3);
      }
      color("#222") translate([0, clamp_y, 0]) {
         translate([0, 0, ext]) cylinder(d = clamp_pad_d, h = 3);
         translate([0, 0, -desk.z - 3]) cylinder(d = clamp_pad_d, h = 3);
      }
   }
}

module clamps_part() {
   for (x = clamp_xs) desk_clamp_part(x);
}

// --- Sheet, x / z on the sheet ---

module rect(r) {
   translate([r[0], r[1]]) square([r[2] - r[0], r[3] - r[1]]);
}

module sheet_2d() {
   difference() {
      translate([0, -ext]) square([frame_w, sheet_h + ext]);
      for (c = cuts) rect(c);
      for (p = sheet_screws)
         translate(p) circle(d = m5_d);
   }
}

// apron sheet, x / z on the sheet (z < 0)
module apron_2d() {
   difference() {
      translate([apron[0], -apron_h]) square([apron[1] - apron[0], apron_h - ext]);
      rect(pedestal_cut);
      rect(flaps_cut);
      for (p = apron_screws)
         translate(p) circle(d = m5_d);
   }
}

module sheet_part() {
   color(c_sheet)
      rotate([90, 0, 0])
         linear_extrude(sheet_t) {
            sheet_2d();
            apron_2d();
         }
}

// --- Components, view only ---

module desk_part() {
   color(c_desk)
      translate([-100, frame_overhang, -desk.z])
         cube([frame_w + 200, desk.y, desk.z]);
}

module yoke_part() {
   x = (x_bay0 + x_bay1) / 2;
   color(c_device) {
      translate([x - yoke_housing.x / 2, yoke_front_y, 0])
         cube(yoke_housing);
      translate([x, yoke_front_y + 1, yoke_shaft_z])
         rotate([90, 0, 0]) cylinder(d = 22, h = 90);
      translate([x, yoke_front_y - 100, yoke_shaft_z]) {
         cube([yoke_wheel_w - 80, 24, 26], center = true);
         for (s = [-1, 1])
            translate([s * (yoke_wheel_w / 2 - 20), 0, 0])
               rotate([0, s * 15, 0]) cylinder(d = 32, h = 110, center = true);
      }
   }
}

module radio_part() {
   translate([x_rc, -sheet_t, radio_front_z0]) {
      color(c_device) {
         translate([-radio_front.x / 2, -radio_front_t, 0])
            cube([radio_front.x, radio_front_t, radio_front.y]);
         translate([-radio_body.x / 2, 0, (radio_front.y - radio_body.y) / 2])
            cube([radio_body.x, radio_depth, radio_body.y]);
      }
      color(c_display)
         for (sx = [-1, 1], z = [0.3, 0.7])
            translate([sx * radio_front.x / 4 - 45, -radio_front_t - 0.5, z * radio_front.y - 6])
               cube([90, 1, 12]);
   }
}

module switch_panel_part() {
   f = switch_flange;
   y_face = -sheet_t - 3;           // panel_t, the face on the sheet
   z_back = switch_z + f;
   color(c_sheet) {
      translate([x_sw0, y_face, switch_z])
         cube([f + switch_ign_w - 0.3, 3, switch_panel.y]);
      translate([x_sw0 + f + switch_ign_w, y_face, switch_z])
         cube([switch_panel.x - f - switch_ign_w, 3, switch_panel.y]);
      // rims, through the sheet
      for (p = [[x_sw0 + f, switch_ign_w - 0.3], [x_sw0 + f + switch_ign_w, switch_back.x - switch_ign_w]])
         difference() {
            translate([p[0], y_face + 3, z_back]) cube([p[1], 8, switch_back.y]);
            translate([p[0] + 2.5, y_face, z_back + 2.5]) cube([p[1] - 5, 20, switch_back.y - 5]);
         }
   }
   color(c_switch)
      translate([switch_cut[0] + 4, 5, switch_cut[1] + 4])
         cube([switch_cut[2] - switch_cut[0] - 8, switch_depth, switch_cut[3] - switch_cut[1] - 8]);
   // key, rockers and toggles on the face
   color("#b9c0c8") translate([x_sw0 + f + 38.5, y_face, z_back + 40]) rotate([90, 0, 0]) cylinder(d = 24, h = 4);
   color("#c0392b") translate([x_sw0 + f + 92, y_face - 4, z_back + 22]) cube([24, 4, 31]);
   color("#222") translate([x_sw1 - f - 32, y_face - 4, z_back + 22]) cube([24, 4, 31]);
   for (i = [0 : 6])
      color("#d0d4da") translate([x_sw0 + f + 132 + i * 18, y_face, z_back + 36])
         rotate([90, 0, 0]) cylinder(d = 4, h = 18);
}

// Primer: face, tube through the sheet, bracket behind it, knob
module primer_part() {
   y_face = -sheet_t - 3;           // panel_t
   color(c_sheet)
      translate([primer_face_r[0], y_face, primer_face_r[1]]) cube([primer_face, 3, primer_face]);
   color("#3d7bd9") {
      translate([primer_x - 11, y_face + 3, primer_z - 11]) cube([22, primer_tube, 22]);
      translate([primer_x - 11, y_face + 3 + primer_tube, primer_z - primer_bracket.y / 2])
         cube([11 + primer_bracket.x, primer_bracket.z, primer_bracket.y]);
   }
   color("#b9c0c8")
      translate([primer_x, y_face + 3 + primer_tube, primer_z]) rotate([-90, 0, 0]) cylinder(d = 6, h = primer_depth - primer_tube);
   color("#1d1f22")
      translate([primer_x, y_face, primer_z]) rotate([90, 0, 0]) cylinder(d = 22, h = 14);
}

module throttle_part() {
   r = 10;
   f = throttle_flange;
   translate([throttle_x0, throttle_y0, ext]) {
      color(c_box) {
         difference() {
            hull()
               for (x = [r, throttle_size.x - r], y = [r, throttle_size.y - r])
                  translate([x, y, 0]) cylinder(r = r, h = throttle_size.z);
            translate([3, 3, 3]) cube(throttle_size - [6, 6, 0]);
         }
         translate([-f, 0, 0]) cube([throttle_size.x + 2 * f, throttle_face_t, throttle_size.z + f]);
      }
      color("#b9c0c8")
         for (x = throttle_bolt_xs)
            translate([x, throttle_bolt_y, 3]) cylinder(d = m5_head_d, h = 3);
      for (i = [0 : 2])
         translate([throttle_rod_xs[i], 0, throttle_rod_z]) {
            color("#b9c0c8") rotate([90, 0, 0]) cylinder(d = 6, h = 60);
            color(["#9aa0a8", "#222", "#c0392b"][i])
               translate([0, -60, 0]) rotate([90, 0, 0]) cylinder(d = 26, h = 14);
         }
   }
}

// Under-desk component on its lower bar: box, face with flange, floor bolts
module under_box(x, size) {
   f = under_flange;
   translate([x - size.x / 2, under_y0, apron_bar_z]) {
      color(c_box) {
         difference() {
            cube(size);
            translate([3, 3, 3]) cube(size - [6, 6, 0]);
         }
         translate([-f, 0, 0]) cube([size.x + 2 * f, under_face_t, size.z + f]);
      }
      color("#b9c0c8")
         for (s = [-1, 1])
            translate([size.x / 2 + s * size.x / 4, under_bolt_y, 3]) cylinder(d = m5_head_d, h = 3);
   }
}

module pedestal_part() {
   under_box(pedestal_x, pedestal_size);
   // trim wheel rim out of a slot in the face, trim indicator slot below it
   z = apron_bar_z + pedestal_size.z;
   color("#222")
      translate([pedestal_x - 6, under_y0 + 40, z - 55])
         rotate([0, 90, 0]) cylinder(d = 100, h = 12);
   color("#ddd")
      translate([pedestal_x - 4, under_y0 - 0.5, apron_bar_z + 12]) cube([8, 1, 28]);
}

// DIY flaps panel (placeholder): front plate on the apron sheet, body behind it,
// lever and indicator on the plate
module flaps_part() {
   y = -sheet_t;
   color(c_device) {
      translate([flaps_face[0], y - 3, flaps_face[1]])
         cube([flaps_plate.x, 3, flaps_plate.y]);
      translate([flaps_x - flaps_body.x / 2, 0, flaps_z - flaps_body.y / 2])
         cube([flaps_body.x, flaps_body.z - sheet_t, flaps_body.y]);
   }
   color("#ddd") translate([flaps_x - 18, y - 3.5, flaps_z - 20]) cube([2, 1, 40]);
   color("#eee") translate([flaps_x + 4, y - 15, flaps_z + 8]) cube([16, 12, 6]);
}

// Parking brake: body under the desk top behind the bottom bar, a tab up to
// the bar's bottom slot; the T-handle released (sideways, almost flush) or
// set (pulled out, pointing down)
module park_part(set = false) {
   z = park_z + park_size.z / 2;
   pull = set ? park_pull : 0;
   color(c_box) {
      translate([park_x - park_size.x / 2, 0, park_z]) cube(park_size);
      translate([park_x - park_size.x / 2, 0, park_z]) cube([park_size.x, ext, -ext - park_z]);
   }
   color("#b9c0c8") {
      for (s = [-1, 1])
         translate([park_x + s * park_bolt_dx, ext / 2, -ext]) cylinder(d = 5, h = 1);
      translate([park_x, 1, z]) rotate([90, 0, 0]) cylinder(d = 6, h = 6 + pull);
   }
   color("#c0392b")
      translate([park_x, -10 - pull, z])
         rotate([0, set ? 0 : 90, 0])
            translate([0, 0, set ? -park_handle + 8 : 0])
               cylinder(d = 10, h = park_handle, center = !set);
}

module components() {
   yoke_part();
   radio_part();
   switch_panel_part();
   primer_part();
   throttle_part();
   pedestal_part();
   flaps_part();
   park_part();
   clamps_part();
}

module cockpit_view() {
   desk_part();
   frame_part();
   sheet_part();
   components();
}

// Sheet cutting view: the sheet with the frame behind it
module sheet_view() {
   frame_part();
   sheet_part();
}

// Below the desk top: the apron, under-desk components and the leg room
module under_view() {
   intersection() {
      union() {
         desk_part();
         frame_part();
         sheet_part();
         pedestal_part();
         flaps_part();
         park_part(set = true);
         clamps_part();
         throttle_part();
      }
      translate([-110, -200, -apron_h - 1]) cube([frame_w + 220, 600, apron_h + 120]);
   }
}

// Close-up of the left desk clamp, the desk and the frame around it cut off
module clamp_view() {
   x0 = rails[0][0] - 40;
   x1 = 60;
   color(c_desk) translate([x0, frame_overhang, -desk.z]) cube([x1 - x0, 110, desk.z]);
   color(c_alu) {
      translate([rails[0][0], ext, 0]) cube([x1 - rails[0][0], ext, ext]);
      translate([0, 0, -ext]) cube([x1, ext, ext]);
      translate([0, 0, 0]) cube([ext, ext, 70]);
      translate([0, 2 * ext, 0]) cube([ext, 90, ext]);
   }
   color(c_sheet) translate([0, -sheet_t, -ext]) cube([x1, sheet_t, ext + 70]);
   desk_clamp_part(clamp_xs[0]);
}

module throttle_view() {
   intersection() {
      union() {
         frame_part();
         sheet_part();
         throttle_part();
      }
      translate([throttle_x0 - 40, -100, -1]) cube([throttle_size.x + 80, 400, 120]);
   }
}

//cockpit_view(); // Make view main 62,0,-35
//cockpit_view(); // Make view front 90,0,0
//cockpit_view(); // Make view back 55,0,150
//frame_part(); // Make view frame 55,0,-35
//sheet_view(); // Make view sheet 90,0,0
//throttle_view(); // Make view throttle 55,0,150
//under_view(); // Make view under 80,0,-20
//clamp_view(); // Make view clamp 75,0,-50
