robertbraeutigam/cessna172/switchpanel/switches.scad

// Switch panel: master, lights, avionics
//
// The switch row, separate from the ignition: the red split MASTER (ALT,
// BAT) on the left, toggle switches in the middle and the split AVIONICS
// (BUS 1, BUS 2) on the right. Up is ON, like in the airplane.
//
// - MASTER and AVIONICS are double rocker switches (two independent
//   rockers in one housing, 6 pins). They snap into a cutout from the
//   front: ramps on their top and bottom end catch behind the panel, which
//   is thinned to rk_grip there by a pocket in the back.
// - The middle switches are toggle switches with an M12 neck and an 18 mm
//   lever, about the size of the real ones. They go in from the back and
//   a nut on the front clamps them. Their body sits in a shallow pocket in
//   the back so they cannot turn.
// - Above the toggles is a row of circuit breakers, like in the 172N, with
//   their names above them. They are for show only: printed dummy
//   push-to-reset buttons (hex nut, button with the rating on it), glued
//   into hex holes in the face.
// - The front is a separate thin face (face_t, panel.inc.scad) with the
//   labels standing out of it, to be painted with a white paint pen. It is
//   printed front side up, the panel behind it front side down, so neither
//   needs supports. The toggle nuts, the rocker lips and the mount screws
//   clamp it on.
// - A rim on the back stiffens the long, thin panel; it goes through the
//   hole in the cockpit sheet and the face flange around it is screwed onto
//   the sheet. It mounts to the right of the ignition panel and has the same
//   height, rim, flange and mount holes (panel.inc.scad); its left corners
//   are square and without a flange where they meet.
// - A CD74HC4067 input multiplexer board sits on two standoffs on the back,
//   in the strip behind the group labels. All switches (and the ignition)
//   are soldered to it, so only one Cat5 cable runs to the hub (port 3).
//   The cable is soldered straight to the mux (no connector, the plug at
//   the hub end is the only one) and a cable tie holds it on a block next
//   to the mux, so pulling the cable does not pull the solder joints.
//
// Wiring: every switch closes one contact: one side to a common GND wire,
// the other to a mux input (active low, like any switch to GND). ALT and
// BAT are independent, there is no mechanical interlock between them.
// Mux inputs C0.. are the switches in label order, then the ignition
// positions (details in the README).
//
// Coordinates: the front of the panel is at z=0, +z points towards the
// pilot, x to the pilot's right, y up. The panel starts at x=-margin_x, the
// switch centers are at y=0. The face is in front of z=-face_t.
//
// Parts to buy (details in the README):
// - 1 red and 1 black double rocker switch, 6 pin
// - 7 toggle switches, M12 neck (2 pin ON-OFF or 6 pin ON-ON)
// - mount_count x M3 screws to mount the panel
// - CD74HC4067 16 channel mux breakout board, 2 x M2 x 6 screws
// - a stranded copper Cat5 patch cable (cut off at one end), a cable tie
// - glue for the printed dummy breakers
// - wire: one GND wire daisy chained over all switches, one wire per switch
//
// Assembly: solder the wires to the switches first (the rockers are hard to
// get out again), put the toggles in from the back and tighten their nuts,
// snap the rockers in from the front, solder the other wire ends to the mux
// and screw it onto its standoffs, solder the Cat5 cable to the mux control
// row and tie it onto its block, glue the dummy breakers into their
// pockets, then mount the panel. The face goes on before the toggle nuts
// and the rockers.

$fn = 48;

include <panel.inc.scad>

// Preview: which switches are shown ON, in label order (missing ones are OFF)
view_on = [1, 1, 0, 1, 0, 0, 1, 1, 0, 1, 1];

// --- Printer ---
bed = [255, 255];            // Kobra 3 V2

// --- Double rocker switch, 6 pin (MEASURE: from the listing) ---
rk_bezel = [24.3, 31.3];     // front lip, width x height
rk_bezel_t = 2;
rk_bezel_r = 1.5;
rk_cutout = [22, 28.5];      // panel cutout
rk_cutout_clear = 0.15;      // added on every side of the cutout
rk_body = [21.7, 25.3];      // body behind the ramps
rk_depth = 31.5;             // front of the lip to the end of the pins
rk_tab = [4.8, 0.8, 7];      // quick connect tabs, width x thickness x length
rk_pin_pitch = 7;            // 3 tabs per rocker, in a column (guess)
rk_grip = 1.5;               // MEASURE: panel thickness the ramps snap behind
rk_clip_room = [0, 1.5];     // room for the ramps behind the panel, per side
rk_frame = 1.5;              // lip around and between the two rockers
rk_rocker_h = 3;             // rocker center height in front of the lip
rk_rocker_tilt = 10;

// --- Toggle switch ---
toggle = "M12";              // "M12" (standard size, like the real ones) or "MTS-202" (mini, M6)
mts = toggle == "MTS-202";
// MEASURE: M12 values from the listing (30 x 15.5 x 15 mm, 12 mm neck,
// 18 mm lever), the rest are guesses
tg_thread_d = mts ? 6 : 12;
tg_hole = tg_thread_d + 0.2;
tg_thread_len = mts ? 9 : 9.5;  // from the body (guess for M12)
tg_body = mts ? [12.8, 11.4] : [15.5, 15];  // body, orientation unknown (the pocket is square)
tg_depth = mts ? 14 : 30;    // top of the body to the end of the lugs
tg_tab = mts ? [2, 0.5, 4.5] : [3, 0.8, 7];
tg_body_depth = tg_depth - tg_tab.z;
tg_nut_af = mts ? 8 : 14;    // nut across flats
tg_nut_t = mts ? 2 : 2.5;
tg_washer_d = mts ? 10 : 15;
tg_washer_t = 0.6;
tg_lever_len = mts ? 10 : 18;
tg_lever_d = mts ? [3, 2.4] : [4.5, 3.2];  // base, tip
tg_lever_tilt = 14;
tg_pin_pitch = mts ? [4.7, 4.7] : [7, 6];  // between the 2 poles, along the throw
tg_pitch = 19;
tg_pocket_depth = 1;         // body pocket in the back, keeps the toggle from turning

// --- Input multiplexer, CD74HC4067 breakout (MEASURE: from listings) ---
mux_board = [40.6, 18];      // PCB, along the pin rows x across
mux_board_t = 1.6;
mux_holes = [[-17.5, 0], [17.5, 0]];  // MEASURE: guess, from the board center
mux_hole_d = 2.2;            // in the board, for the view
mux_pin_inset = 1.3;         // pin row to the board edge
mux_pin_stub = 3;            // wire ends and solder below the board
mux_channels = 16;
mux_ctl_names = ["SIG", "S3", "S2", "S1", "S0", "EN", "VCC", "GND"];  // MEASURE: order on the board
ignition_inputs = 5;         // OFF, R, L, BOTH, START, after the switches
mux_x = 45;                  // board center; left half, the ignition is left of the panel
mux_standoff_d = 6;
mux_standoff_h = 5;          // panel back to the board
mux_screw_hole = 2.1;        // M2 pilot hole
mux_clear = 0.3;

// --- Cable to the hub: soldered to the mux, tied down next to it ---
cable_d = 6;                 // Cat5 patch cable (MEASURE)
tie = [3.6, 1.3];            // cable tie, width x thickness
tie_clear = 0.6;             // added to the tie's width and thickness in the slot
tie_block = [10, 13, 6];     // along the cable (x) x across x height off the panel back
tie_groove = 1.5;            // cable groove in the block top
tie_gap = 12;                // mux board edge to the block, the wires fan out there

// --- Layout ---
// Groups from left to right: label above the group, type ("rocker2" or
// "toggle"), switch labels (one list of lines each, top line first), color.
// A rocker2 group is one double rocker, so it has exactly two switches.
groups = [
   ["MASTER", "rocker2", [["ALT"], ["BAT"]], "red"],
   ["", "toggle", [["FUEL", "PUMP"], ["BEACON"], ["LAND"], ["TAXI"], ["NAV"], ["STROBE"], ["PITOT", "HEAT"]], "chrome"],
   ["AVIONICS", "rocker2", [["BUS", "1"], ["BUS", "2"]], "black"],
];
group_space = 4;             // between two groups

// --- Circuit breakers, for show ---
// Name engraved above the breaker, rating (A) on its button. In a row over
// the first toggle group, one above each toggle, from the left.
breakers = [
   ["FUEL PUMP", 5], ["BCN", 5], ["LAND LT", 15], ["TAXI LT", 10],
   ["NAV LT", 10], ["STROBE", 5], ["PITOT HT", 10]
];
cb_nut_af = 11;              // hex nut across flats
cb_nut_t = 2.5;              // of which cb_pocket_depth sits in the panel
cb_pocket_depth = face_t;    // hex hole in the face, locates the breaker for gluing
cb_pocket_clear = 0.15;      // added on every side of the pocket
cb_button_d = 6.5;
cb_button_h = 4;             // above the nut
cb_button_chamfer = 0.5;
cb_rating_size = 2.6;        // number engraved into the button
cb_rating_depth = 0.4;
cb_label_size = 2.2;
cb_label_gap = 1.5;          // nut to its label
cb_gap = 2;                  // top of the toggle labels to the nuts
cb_print_space = 3;          // between the breakers on the print bed

// --- Panel (height, thickness, rim, mount holes, font: panel.inc.scad) ---
margin_x = 11;               // panel end to the outer switches, room for the group labels
margin_bottom = 12;          // at least, panel bottom to the rockers
margin_top = 4;              // at least, panel top to the top label
mount_center = true;         // also a hole in the middle of the top and bottom edge

// --- Labels, standing out of the face ---
label_line = 4.2;            // line pitch of two-line labels
label_gap = 2.5;             // switch to the lowest label line
group_line_w = 0.6;          // line under a group label, over its switches

// --- Derived ---
rk_cutout_c = rk_cutout + 2 * [rk_cutout_clear, rk_cutout_clear];
rk_pocket = rk_cutout_c + 2 * rk_clip_room;
rk_window = [(rk_bezel.x - 3 * rk_frame) / 2, rk_bezel.y - 2 * rk_frame];
rk_dx = (rk_window.x + rk_frame) / 2;              // rocker centers at +-rk_dx
rk_body_depth = rk_depth - rk_bezel_t - rk_tab.z;  // body behind the front of the panel
tg_pocket = [1, 1] * (max(tg_body) + 0.4);      // square: fits either way, still cannot turn
tg_body_z = -panel_t + tg_pocket_depth;            // top of the toggle body
tg_front_r = max(tg_washer_d, tg_nut_af / cos(30)) / 2;

function count_before(g) = g == 0 ? 0 : count_before(g - 1) + len(groups[g - 1][2]);
function group_w(g) = groups[g][1] == "rocker2" ? rk_bezel.x : len(groups[g][2]) * tg_pitch;
function group_left(g) = g == 0 ? 0 : group_left(g - 1) + group_w(g - 1) + group_space;

// One entry per switch unit: [x, type, labels, color, index of its first switch]
units = [for (g = [0 : len(groups) - 1])
            for (u = groups[g][1] == "rocker2" ? [0] : [for (i = [0 : len(groups[g][2]) - 1]) i])
               groups[g][1] == "rocker2"
                  ? [group_left(g) + rk_bezel.x / 2, "rocker2", groups[g][2], groups[g][3], count_before(g)]
                  : [group_left(g) + (u + 0.5) * tg_pitch, "toggle", [groups[g][2][u]], groups[g][3], count_before(g) + u]];
switch_count = count_before(len(groups));

function is_rocker(u) = u[1] == "rocker2";
function unit_label_xs(u) = is_rocker(u) ? [u[0] - rk_dx, u[0] + rk_dx] : [u[0]];
function unit_pocket(u) = is_rocker(u) ? rk_pocket : tg_pocket;
function unit_front_w(u) = is_rocker(u) ? rk_bezel.x : 2 * tg_front_r;

rk_label_y = rk_bezel.y / 2 + label_gap;
tg_label_y = tg_front_r + label_gap;
function unit_label_y(u) = is_rocker(u) ? rk_label_y : tg_label_y;
group_line_y = rk_label_y + label_line + label_size + 1;
group_label_y = group_line_y + group_line_w + 1.5;

// Breakers: centered over the first toggle group, at the toggle pitch
cb_group = [for (g = [0 : len(groups) - 1]) if (groups[g][1] == "toggle") g][0];
cb_r = cb_nut_af / cos(30) / 2;                    // nut corner radius
cb_xs = [for (i = [0 : len(breakers) - 1])
            group_left(cb_group) + (i + 0.5 + (len(groups[cb_group][2]) - len(breakers)) / 2) * tg_pitch];
tg_label_top = tg_label_y + (max([for (u = units) if (!is_rocker(u)) len(u[2][0])]) - 1) * label_line + label_size;
cb_y = tg_label_top + cb_gap + cb_r;
cb_label_y = cb_y + cb_r + cb_label_gap;
cb_label_top = cb_label_y + cb_label_size;
function cb_label_w(i) = len(breakers[i][0]) * cb_label_size * 0.75;  // estimate, for the checks

panel_x0 = -margin_x;
panel_x1 = group_left(len(groups) - 1) + group_w(len(groups) - 1) + margin_x;
// The panel is panel_h high, like the ignition panel next to it. The room
// left over goes half below and half above the switches.
content_y0 = -rk_bezel.y / 2 - margin_bottom;
content_y1 = max(group_label_y + group_label_size, len(breakers) > 0 ? cb_label_top : 0) + margin_top;
panel_y0 = content_y0 - (panel_h - (content_y1 - content_y0)) / 2;
panel_y1 = panel_y0 + panel_h;
panel_size = [panel_x1 - panel_x0, panel_y1 - panel_y0];   // the back
face_size = panel_size + [flange_w, 2 * flange_w];             // flange on the top, bottom and right
panel_cx = (panel_x0 + panel_x1) / 2;

// The top middle hole goes between the two breakers nearest the middle
function closest(v, x) = [for (a = v) if (abs(a - x) == min([for (b = v) abs(b - x)])) a][0];
mount_top_cx = len(breakers) > 1 ? closest([for (i = [1 : len(cb_xs) - 1]) (cb_xs[i - 1] + cb_xs[i]) / 2], panel_cx) : panel_cx;
mount_holes = concat(
   panel_corner_holes(panel_x0, panel_x1, panel_y0, round0 = false),
   mount_center ? [[panel_cx, panel_mount_y0(panel_y0)], [mount_top_cx, panel_mount_y1(panel_y0)]] : []);
mount_count = len(mount_holes);

// Mux board as high as the rim allows. Its panel side is at mux_z.
mux_y = panel_y1 - rim_w - mux_clear - mux_board.y / 2;
mux_z = -panel_t - mux_standoff_h;
mux_switch_y = max(rk_cutout_c.y, tg_pocket.y) / 2;  // the switches reach up to here behind the panel
function mux_ch_pin(i) = [mux_x + (i - 7.5) * 2.54, mux_y - mux_board.y / 2 + mux_pin_inset];
function mux_ctl_pin(name) = [mux_x + (search([name], mux_ctl_names)[0] - 3.5) * 2.54,
                              mux_y + mux_board.y / 2 - mux_pin_inset];
// Cable tie block, right of the mux; the cable runs along x on its top
tie_x = mux_x + mux_board.x / 2 + tie_gap + tie_block.x / 2;
tie_y = mux_y;
tie_slot = tie + [tie_clear, tie_clear];

// Distance from a point to a centered box
function box_dist(p, c, size) = norm([max(0, abs(p.x - c.x) - size.x / 2), max(0, abs(p.y - c.y) - size.y / 2)]);
min_web = min([for (i = [1 : len(units) - 1])
                  units[i][0] - units[i - 1][0] - (unit_pocket(units[i]).x + unit_pocket(units[i - 1]).x) / 2]);
min_front_gap = min([for (i = [1 : len(units) - 1])
                  units[i][0] - units[i - 1][0] - (unit_front_w(units[i]) + unit_front_w(units[i - 1])) / 2]);
mount_head_r = 2.8;          // pan head on the front
// Mount screw heads to the breaker nuts and labels
min_cb_mount_dist = len(breakers) == 0 ? 99 : min([for (h = mount_holes, i = [0 : len(breakers) - 1])
                  min(norm(h - [cb_xs[i], cb_y]) - cb_r,
                      box_dist(h, [cb_xs[i], cb_label_y + cb_label_size / 2], [cb_label_w(i), cb_label_size]))]) - mount_head_r;

echo(panel_size = panel_size, face_size = face_size, switches = switch_count, mux_inputs = switch_count + ignition_inputs, breakers = len(breakers));

// --- Sanity checks ---
assert(face_size.x <= bed.x && face_size.y <= bed.y, "Panel does not fit the printer bed");
assert(content_y1 - content_y0 <= panel_h, "Switches and labels do not fit panel_h, make it higher or the margins smaller");
assert([for (g = groups) if (g[1] == "rocker2" && len(g[2]) != 2) g] == [], "A rocker2 group needs exactly two switches");
assert(panel_t - rk_grip >= 1, "Rocker pockets too shallow, make panel_t thicker or rk_grip thinner");
assert(rk_grip - face_t >= 0.4, "Panel ledge behind the face too thin around the rockers");
assert(rk_cutout.x >= rk_body.x && rk_cutout.y >= rk_body.y, "Rocker body does not fit the cutout");
assert(rk_bezel.x >= rk_cutout_c.x + 1.5 && rk_bezel.y >= rk_cutout_c.y + 1.5, "Rocker lip does not cover the cutout");
assert(tg_thread_len + tg_body_z >= tg_washer_t + tg_nut_t + 1, "Toggle thread too short for the panel");
assert(tg_pocket_depth <= panel_t - face_t - 0.8, "Toggle body pocket too deep");
assert(norm(tg_body) >= tg_pocket.x + 1, "Toggle body could turn in its square pocket");
assert(min_front_gap >= 1, "Switches too close to each other, increase tg_pitch or group_space");
assert(min_web >= 1.2, "Too thin a wall between two pockets, increase tg_pitch or group_space");
assert(panel_y0 + rim_w + 0.5 <= -max(rk_pocket.y, tg_pocket.y) / 2, "Rim runs into a switch pocket, increase margin_bottom");
assert(len(view_on) <= switch_count, "view_on has more entries than there are switches");
assert(switch_count + ignition_inputs <= mux_channels, "More switches than mux inputs");
assert(mux_y - mux_board.y / 2 >= mux_switch_y + mux_clear, "Mux board runs into the switches, increase margin_top");
assert(mux_x - mux_board.x / 2 >= panel_x0 + rim_w + mux_clear && mux_x + mux_board.x / 2 <= panel_x1 - rim_w - mux_clear,
       "Mux board does not fit inside the rim, move mux_x");
assert(mux_standoff_h >= mux_pin_stub + 1, "Mux standoffs too short for the pin ends");
assert(mux_standoff_d >= mux_screw_hole + 3, "Mux standoff wall too thin");
assert(tie_x + tie_block.x / 2 <= panel_x1 - rim_w - 1, "Cable tie block does not fit inside the rim, move mux_x");
assert(tie_y - tie_block.y / 2 >= mux_switch_y + mux_clear && tie_y + tie_block.y / 2 <= panel_y1 - rim_w,
       "Cable tie block runs into the switches or the rim");
assert(tie_block.y >= cable_d + 2 * tie_slot.y + 2, "Cable tie block too narrow for the cable");
assert(tie_block.z - tie_groove - tie_slot.y >= 2, "Cable tie block too thin above the slot");
assert(tie_block.x >= tie_slot.x + 4, "Cable tie block too short for the slot");
assert(len(breakers) <= len(groups[cb_group][2]), "More breakers than toggles below them");
assert(tg_pitch >= 2 * cb_r + 1.5 && tg_pitch >= max([for (i = [0 : len(breakers) - 1]) cb_label_w(i)]) + 1, "Breakers too close to each other, increase tg_pitch");
assert(cb_pocket_depth < cb_nut_t, "Breaker nut sunk completely into the panel");
assert(min_cb_mount_dist >= 0.5, "A mount screw runs into a breaker or its label");
assert(cb_rating_size * 1.4 <= cb_button_d - 2 * cb_button_chamfer, "Breaker rating too big for the button");

// --- Helpers ---
module rrect(size, r) {
   offset(r = r)
      square(size - 2 * [r, r], center = true);
}

module labels_2d() {
   for (u = units) {
      xs = unit_label_xs(u);
      for (j = [0 : len(xs) - 1]) {
         lines = u[2][j];
         for (i = [0 : len(lines) - 1])
            translate([xs[j], unit_label_y(u) + i * label_line])
               text(lines[len(lines) - 1 - i], size = label_size, font = font, halign = "center");
      }
   }
   for (g = [0 : len(groups) - 1])
      if (groups[g][0] != "") {
         x0 = group_left(g);
         x1 = x0 + group_w(g);
         translate([(x0 + x1) / 2, group_label_y])
            text(groups[g][0], size = group_label_size, font = font, halign = "center");
         translate([x0, group_line_y])
            square([x1 - x0, group_line_w]);
      }
   for (i = [0 : len(breakers) - 1])
      translate([cb_xs[i], cb_label_y])
         text(breakers[i][0], size = cb_label_size, font = font, halign = "center");
}

module cb_rating_2d(amps) {
   text(str(amps), size = cb_rating_size, font = font, halign = "center", valign = "center");
}

// --- Parts ---
module panel() {
   difference() {
      union() {
         // Square corners on the left, where the ignition panel is
         mirror([0, 0, 1])
            panel_blank(panel_x0, panel_x1, panel_y0, mount_holes, round0 = false);
         for (h = mux_holes)
            translate([mux_x + h.x, mux_y + h.y, mux_z])
               cylinder(d = mux_standoff_d, h = mux_standoff_h + 0.01);
         tie_block();
      }
      // Mux screw holes, not through the front
      for (h = mux_holes)
         translate([mux_x + h.x, mux_y + h.y, mux_z - 1])
            cylinder(d = mux_screw_hole, h = mux_standoff_h + 2);
      for (u = units)
         translate([u[0], 0, 0])
            if (is_rocker(u)) {
               translate([0, 0, -panel_t - 1])
                  linear_extrude(panel_t + 2)
                     square(rk_cutout_c, center = true);
               // Thin the panel for the snap ramps
               translate([0, 0, -panel_t - 1])
                  linear_extrude(panel_t - rk_grip + 1)
                     square(rk_pocket, center = true);
            } else {
               translate([0, 0, -panel_t - 1])
                  cylinder(d = tg_hole, h = panel_t + 2);
               // Body pocket, keeps the toggle from turning
               translate([0, 0, -panel_t - 1])
                  linear_extrude(tg_pocket_depth + 1)
                     square(tg_pocket, center = true);
            }
      // Room for the face
      translate([0, 0, -face_t])
         linear_extrude(face_t + 1)
            offset(delta = 1)
               panel_face_2d(panel_x0, panel_x1, panel_y0, round0 = false);
      // Version on the back, mirrored so it reads from behind
      translate([panel_x1 - 30, panel_y1 + flange_w / 2, -panel_t - 1])
         linear_extrude(gitrev_depth + 1)
            mirror([1, 0])
               text("{{gitrev}}", size = 3, halign = "center", valign = "center");
   }
}

// Front face from z=-face_t to 0, the labels stand out in front of it
module face() {
   translate([0, 0, -0.01])
      linear_extrude(label_raise + 0.01)
         labels_2d();
   translate([0, 0, -face_t])
      linear_extrude(face_t)
         difference() {
            panel_face_2d(panel_x0, panel_x1, panel_y0, round0 = false);
            for (u = units)
               translate([u[0], 0])
                  if (is_rocker(u))
                     square(rk_cutout_c, center = true);
                  else
                     circle(d = tg_hole);
            // Breaker pockets
            for (x = cb_xs)
               translate([x, cb_y])
                  circle(r = cb_r + cb_pocket_clear / cos(30), $fn = 6);
            for (h = mount_holes)
               translate(h)
                  circle(d = mount_d);
         }
}

// Breaker button with the rating engraved, on z=0
module cb_button(amps) {
   difference() {
      cylinder(d = cb_button_d, h = cb_button_h);
      translate([0, 0, cb_button_h - cb_button_chamfer])
         difference() {
            cylinder(d = cb_button_d + 1, h = cb_button_chamfer + 1);
            cylinder(d1 = cb_button_d, d2 = cb_button_d - 2 * (cb_button_chamfer + 1), h = cb_button_chamfer + 1);
         }
      translate([0, 0, cb_button_h - cb_rating_depth])
         linear_extrude(cb_rating_depth + 1)
            cb_rating_2d(amps);
   }
}

// Dummy breaker, back of the nut at z=0
module breaker(amps) {
   cylinder(r = cb_r, h = cb_nut_t, $fn = 6);
   translate([0, 0, cb_nut_t - 0.01])
      cb_button(amps);
}

// All breakers in a row, as they are printed: nut down
module breakers_plate() {
   for (i = [0 : len(breakers) - 1])
      translate([i * (2 * cb_r + cb_print_space), 0, 0])
         breaker(breakers[i][1]);
}

// --- Views (rendered to PNG by "make views") ---

c_cut = "#3d7bd9";           // panel in the section views
c_body = "#2a2b2e";
c_bezel = "#1b1c1e";
c_tab = "#d9b24a";
c_steel = "#b9c0c8";
c_chrome = "#e2e6ea";
c_line = "#8fd0ff";
c_gnd = "#1d1f22";
c_pcb = "#5a3d8a";
wire_colors = ["#e8433a", "#f5a030", "#f2d03b", "#4caf50", "#3d7bd9", "#8e5bd6", "#9aa3ad", "#eceff2"];
wire_d = 1.2;
c_cable = "#8fa3b8";
// Cat5 pairs on the mux control pins (T568B, README Port pinout)
cat5_names = ["S0", "S1", "S2", "VCC", "GND", "S3", "SIG"];
cat5_colors = ["#f8d2a8", "#f5a030", "#c4e6bf", "#3d7bd9", "#c3d6f5", "#4caf50", "#e3d2c0"];

function rocker_color(name) = name == "red" ? "#d33a2c" : name == "white" ? "#eeeeea" : "#26282b";
function is_on(i) = i < len(view_on) && view_on[i] == 1;

// Keeps x <= 0 if cut is set (section views). color() outside of it also
// colors the cut faces.
module cut_if(cut) {
   // render() so the preview draws clean cut faces
   if (cut)
      render()
         intersection() {
            children();
            translate([-100, -100, -100])
               cube([100, 200, 200]);
         }
   else
      children();
}

// Quick connect / solder tabs at the given xy positions, below z
module tabs(points, size, z) {
   color(c_tab)
      for (p = points)
         translate([p.x - size.x / 2, p.y - size.y / 2, z - size.z])
            difference() {
               cube(size);
               if (size.x > 2.5)
                  translate([size.x / 2, -1, size.z - 2.5])
                     rotate([-90, 0, 0])
                        cylinder(d = 1.6, h = 3, $fn = 12);
            }
}

function rocker_tab_points() = [for (x = [-rk_dx, rk_dx], y = [-1, 0, 1]) [x, y * rk_pin_pitch]];

// Double rocker, front of the panel at z=0. on = [left, right]
module rocker2_part(c, on, cut = false) {
   color(c_bezel)
      cut_if(cut)
         difference() {
            linear_extrude(rk_bezel_t)
               rrect(rk_bezel, rk_bezel_r);
            for (x = [-rk_dx, rk_dx])
               translate([x, 0, -1])
                  linear_extrude(rk_bezel_t + 2)
                     square(rk_window, center = true);
         }
   // Up is ON: the top half pressed in, the bottom half sticks out
   color(rocker_color(c))
      cut_if(cut)
         for (i = [0, 1])
            translate([i == 0 ? -rk_dx : rk_dx, 0, 0])
               intersection() {
                  translate([0, 0, -1])
                     linear_extrude(rk_bezel_t + rk_rocker_h + 4)
                        rrect(rk_window - [0.6, 0.6], 0.8);
                  translate([0, 0, rk_bezel_t + rk_rocker_h])
                     rotate([on[i] ? -rk_rocker_tilt : rk_rocker_tilt, 0, 0])
                        translate([-20, -20, -40])
                           cube([40, 40, 40]);
               }
   color(c_body)
      cut_if(cut) {
         translate([0, 0, -rk_body_depth])
            linear_extrude(rk_body_depth)
               square(rk_body, center = true);
         // Snap ramps on the top and bottom end
         for (m = [0, 1])
            mirror([0, m, 0])
               translate([0, rk_body.y / 2 - 0.1, -rk_grip - 0.3])
                  rotate([90, 0, 90])
                     linear_extrude(rk_body.x * 0.6, center = true)
                        polygon([[0, 0], [(rk_cutout.y - rk_body.y) / 2 + 0.1, 0], [0, -6]]);
      }
   tabs(rocker_tab_points(), rk_tab, -rk_body_depth);
}

function toggle_tab_points() = [for (x = [-1, 1], y = [-1, 0, 1]) [x * tg_pin_pitch.x / 2, y * tg_pin_pitch.y]];

// Toggle switch without its front nut, front of the panel at z=0
module toggle_part(on, cut = false) {
   color(c_body)
      cut_if(cut)
         translate([0, 0, tg_body_z - tg_body_depth])
            linear_extrude(tg_body_depth)
               square(tg_body, center = true);
   color(c_chrome)
      cut_if(cut) {
         translate([0, 0, tg_body_z])
            cylinder(d = tg_thread_d, h = tg_thread_len);
         // Lever, ON is up
         translate([0, 0, tg_body_z + tg_thread_len])
            rotate([on ? -tg_lever_tilt : tg_lever_tilt, 0, 0]) {
               sphere(d = tg_thread_d * 0.6);
               cylinder(d1 = tg_lever_d[0], d2 = tg_lever_d[1], h = tg_lever_len);
               translate([0, 0, tg_lever_len])
                  sphere(d = tg_lever_d[1] * 1.15);
            }
      }
   tabs(toggle_tab_points(), tg_tab, tg_body_z - tg_body_depth);
}

module toggle_nut_part(cut = false) {
   color(c_steel)
      cut_if(cut)
         difference() {
            union() {
               cylinder(d = tg_washer_d, h = tg_washer_t);
               translate([0, 0, tg_washer_t])
                  cylinder(d = tg_nut_af / cos(30), h = tg_nut_t, $fn = 6);
            }
            translate([0, 0, -1])
               cylinder(d = tg_thread_d, h = tg_washer_t + tg_nut_t + 2);
         }
}

// Block for the cable tie on the panel back: the tie goes through a slot
// along y at the panel, around the cable lying in the groove on top
module tie_block() {
   translate([tie_x, tie_y, -panel_t])
      mirror([0, 0, 1])
         difference() {
            translate([-tie_block.x / 2, -tie_block.y / 2, -0.01])
               cube(tie_block + [0, 0, 0.01]);
            translate([-tie_slot.x / 2, -tie_block.y / 2 - 1, -1])
               cube([tie_slot.x, tie_block.y + 2, tie_slot.y + 1]);
            translate([-tie_block.x / 2 - 1, 0, tie_block.z + cable_d / 2 - tie_groove])
               rotate([0, 90, 0]) cylinder(d = cable_d, h = tie_block.x + 2);
         }
}

// Mux board with its pin holes, panel side at mux_z
module mux_part() {
   pins = concat([for (i = [0 : mux_channels - 1]) mux_ch_pin(i)],
                 [for (n = mux_ctl_names) mux_ctl_pin(n)]);
   color(c_pcb)
      difference() {
         translate([mux_x, mux_y, mux_z - mux_board_t])
            linear_extrude(mux_board_t)
               square(mux_board, center = true);
         for (p = pins)
            translate([p.x, p.y, mux_z - mux_board_t - 1])
               cylinder(d = 1, h = mux_board_t + 2, $fn = 8);
         for (h = mux_holes)
            translate([mux_x + h.x, mux_y + h.y, mux_z - mux_board_t - 1])
               cylinder(d = mux_hole_d, h = mux_board_t + 2);
      }
   // The chip
   color(c_body)
      translate([mux_x, mux_y, mux_z - mux_board_t - 0.75])
         cube([10, 5.3, 1.5], center = true);
}

module mux_screws() {
   color(c_steel)
      for (h = mux_holes)
         translate([mux_x + h.x, mux_y + h.y, mux_z - mux_board_t]) {
            translate([0, 0, -1.3])
               cylinder(d = 3.8, h = 1.3);
            cylinder(d = 2, h = 6 - mux_board_t);
         }
}

module unit_part(u, cut = false, nuts = true) {
   translate([u[0], 0, 0])
      if (is_rocker(u))
         rocker2_part(u[3], [is_on(u[4]), is_on(u[4] + 1)], cut);
      else {
         toggle_part(is_on(u[4]), cut);
         if (nuts)
            toggle_nut_part(cut);
      }
}

module switches_part() {
   for (u = units)
      unit_part(u);
}

// Breakers in their pockets: steel nut, black button, white rating
module breakers_part() {
   for (i = [0 : len(breakers) - 1])
      translate([cb_xs[i], cb_y, -cb_pocket_depth]) {
         color(c_steel)
            cylinder(r = cb_r, h = cb_nut_t, $fn = 6);
         color(c_body)
            translate([0, 0, cb_nut_t - 0.01])
               cb_button(breakers[i][1]);
         color(c_label)
            translate([0, 0, cb_nut_t + cb_button_h - cb_rating_depth])
               linear_extrude(cb_rating_depth - 0.02)
                  cb_rating_2d(breakers[i][1]);
      }
}

// Panel and face
module panel_part() {
   color(c_panel)
      panel();
   face_part();
}

// Face with the raised labels painted
module face_part() {
   color(c_panel)
      face();
   color(c_label)
      translate([0, 0, label_raise - 0.01])
         linear_extrude(0.02)
            labels_2d();
}

module mount_screws() {
   for (h = mount_holes)
      translate([h.x, h.y, 0])
         mirror([0, 0, 1])
            mount_screw(panel_t + 7, c_steel);  // face, sheet, nut
}

// Wire through a list of points
module wire(points, c) {
   color(c)
      for (i = [1 : len(points) - 1])
         hull() {
            translate(points[i - 1]) sphere(d = wire_d, $fn = 10);
            translate(points[i]) sphere(d = wire_d, $fn = 10);
         }
}

// GND and signal tab of every switch, as [x, y, z of the tab end]. Toggles:
// common (middle) and lower pin of one pole, lever up connects them.
// Rockers: the middle and upper tab of each rocker.
function wire_tabs() = [for (u = units)
   for (p = is_rocker(u) ? [[-rk_dx, 0], [rk_dx, 0]] : [[-tg_pin_pitch.x / 2, 0]])
      is_rocker(u)
         ? [[u[0] + p.x, rk_pin_pitch, -rk_body_depth - rk_tab.z], [u[0] + p.x, 0, -rk_body_depth - rk_tab.z]]
         : [[u[0] + p.x, 0, tg_body_z - tg_body_depth - tg_tab.z], [u[0] + p.x, -tg_pin_pitch.y, tg_body_z - tg_body_depth - tg_tab.z]]];

// GND daisy chained over the switches to the mux GND, a signal wire from
// every switch to its mux input, and the Cat5 cable to the hub, soldered to
// the control row and tied onto its block. The ignition cable (C11..C15,
// VCC, GND) is not shown.
module wires_part() {
   t = wire_tabs();
   z = min([for (w = t) w[0].z]) - 2;
   zb = mux_z - mux_board_t - 0.3;   // solder joints on the outer face of the mux
   gnd = mux_ctl_pin("GND");
   wire(concat(
      [[gnd.x, gnd.y, zb], [gnd.x, gnd.y, z], [gnd.x, t[0][0].y, z]],
      [for (w = t) [w[0].x, w[0].y, z]]), c_gnd);
   for (w = t)
      wire([w[0] + [0, 0, 0.5], [w[0].x, w[0].y, z]], c_gnd);
   for (i = [0 : len(t) - 1]) {
      s = t[i][1];
      p = mux_ch_pin(i);
      zs = z - 2 - (i % 3) * 1.6;
      wire([s + [0, 0, 0.5], [s.x + 1.5, s.y, zs], [s.x + 1.5, p.y - 1.5, zs], [p.x, p.y - 1.5, zs], [p.x, p.y, zb]],
           wire_colors[i % len(wire_colors)]);
   }
   // EN to GND: the mux is always enabled
   en = mux_ctl_pin("EN");
   wire([[en.x, en.y, zb], [en.x, en.y - 1.5, zb - 1], [gnd.x, gnd.y - 1.5, zb - 1], [gnd.x, gnd.y, zb]], c_gnd);
   // Cat5 cable to the hub: its pairs soldered to the control row (T568B
   // colors), the jacket tied onto the block, then over the top rim
   zt = -panel_t - tie_block.z + tie_groove - cable_d / 2;  // cable axis
   x_end = tie_x - tie_block.x / 2 - 2;                     // jacket end
   for (j = [0 : len(mux_ctl_names) - 1])
      if (mux_ctl_names[j] != "EN") {
         p = mux_ctl_pin(mux_ctl_names[j]);
         wire([[p.x, p.y, zb], [p.x, p.y, zb - 2 - j * 0.3], [x_end - 3, tie_y + (j - 3.5) * 0.6, zt],
               [x_end + 0.5, tie_y + (j - 3.5) * 0.6, zt]],
              cat5_colors[search([mux_ctl_names[j]], cat5_names)[0]]);
      }
   // Past the block it bends away from the panel and over the top rim
   x_bend = tie_x + tie_block.x / 2 + cable_d;
   z_over = -panel_t - rim_h - cable_d / 2 - 1;
   path = [[x_end, tie_y, zt], [x_bend, tie_y, zt], [x_bend + 4, tie_y, z_over],
           [x_bend + 4, panel_y1 + 20, z_over]];
   color(c_cable)
      for (i = [1 : len(path) - 1])
         hull() {
            translate(path[i - 1]) sphere(d = cable_d, $fn = 16);
            translate(path[i]) sphere(d = cable_d, $fn = 16);
         }
   // The tie around the cable and through the block
   color(c_gnd)
      translate([tie_x, tie_y, zt])
         rotate([0, 90, 0])
            difference() {
               hull() {
                  cylinder(d = cable_d + 2 * tie.y, h = tie.x, center = true);
                  translate([zt + panel_t + tie_slot.y / 2, 0, 0])
                     cube([tie.y, tie_block.y - 2, tie.x], center = true);
               }
               hull() {
                  cylinder(d = cable_d, h = tie.x + 1, center = true);
                  translate([zt + panel_t + tie_slot.y / 2, 0, 0])
                     cube([0.01, tie_block.y - 2 - 2 * tie.y, tie.x + 1], center = true);
               }
            }
}

module dashed_line(from_z, to_z, d = 0.5) {
   color(c_line, 0.6)
      for (z = [from_z : 6 : to_z - 3])
         translate([0, 0, z])
            cylinder(d = d, h = 3, $fn = 8);
}

module assembled_view() {
   panel_part();
   switches_part();
   breakers_part();
   mux_part();
   mux_screws();
   mount_screws();
}

// The pilot's view
module front_view() {
   assembled_view();
}

module back_view() {
   assembled_view();
   wires_part();
}

// Rockers come in from the front, toggles from the back
module exploded_view(e = 30) {
   color(c_panel)
      panel();
   translate([0, 0, 0.5 * e])
      face_part();
   for (u = units)
      translate([u[0], 0, 0])
         if (is_rocker(u)) {
            dashed_line(0, e - rk_body_depth);
            translate([0, 0, e])
               rocker2_part(u[3], [is_on(u[4]), is_on(u[4] + 1)]);
         } else {
            dashed_line(-e + tg_thread_len, e);
            translate([0, 0, -e])
               toggle_part(is_on(u[4]));
            translate([0, 0, e])
               toggle_nut_part();
         }
   // The breakers are glued in from the front
   for (x = cb_xs)
      translate([x, cb_y, 0])
         dashed_line(0, e);
   translate([0, 0, e])
      breakers_part();
   // The mux goes on from the back
   for (h = mux_holes)
      translate([mux_x + h.x, mux_y + h.y, 0])
         dashed_line(-1.6 * e, mux_z, 0.35);
   translate([0, 0, -e])
      mux_part();
   translate([0, 0, -1.6 * e])
      mux_screws();
   for (h = mount_holes)
      translate([h.x, h.y, 0])
         dashed_line(0, 1.6 * e, 0.35);
   translate([0, 0, 1.6 * e])
      mount_screws();
}

// Panel, face and switch cut vertically through the middle of unit u
module section_view(u, w = 40) {
   color(c_cut)
      render()
         intersection() {
            union() {
               panel();
               face();
            }
            translate([u[0] - w, panel_y0 - 1, -50])
               cube([w, panel_size.y + 2, 100]);
         }
   unit_part(u, cut = true);
}

rotate([0, 180, 0]) panel(); // Make module panel
translate([0, 0, -30]) face(); // Make module face
breakers_plate(); // Make module breakers

//switches_part(); // Ignore module

//assembled_view(); // Make view main -30,0,-12
//front_view(); // Make view front 0,0,0
//back_view(); // Make view back 150,0,195
//exploded_view(); // Make view exploded 62,0,30
//section_view(units[0]); // Make view section_rocker 100,0,70
//section_view(units[4], 1.5 * tg_pitch); // Make view section_toggle 100,0,70
