robertbraeutigam/cessna172/throttle/carb_heat_knob.scad

// Carb heat knob

$fn = 50;

module carb_heat_knob() {
   carb_heat_stem();
   // Head
   difference() {
      hull() {
         translate([0, 0, 15])
            cylinder(d=12, h=1);
         translate([0, 0, 20])
            rotate([180, 0 ,0])
               carb_heat_head();
      }
      translate([0,0,21])
         cylinder(d=18, h=2);
   }
}

module carb_heat_stem() {
   difference() {
      cylinder(d=12, h=15);
      translate([0, 0, -1])
         cylinder(d=6.2, h=15+2);
   }
}

module carb_heat_head() {
   intersection() {
      cube([25, 25, 5], center=true);
      translate([0, 25/2, -25+5/2])
         rotate([90, 0, 0])
            cylinder(d=50, h=25);
   }
   intersection() {
      cube([25, 25, 5], center=true);
      translate([-25/2, 0, -25+5/2])
         rotate([90, 0, 90])
            cylinder(d=50, h=25);
   }
}

module button() {
   translate([0, 0, 25]) {
      cylinder(d=16, h=2);
      translate([0, 0, 2])
         rotate_extrude(convexity = 10)
             translate([7, 0, 0])
                 circle(r = 1, $fn = 100);
   }
}

carb_heat_knob(); // Make module knob

button(); // Make module button
