robertbraeutigam/cessna172/(commit log)

2025-04-04 Add initial design
    [throttle_box.scad]
2025-04-04 Rod support
    [throttle_box.scad]
2025-04-04 Add big linear pot stands
    [throttle_box.scad]
2025-04-04 Add dummy big pots
    [throttle_box.scad]
2025-04-04 Add small pot
    [throttle_box.scad]
2025-04-04 Add pot mounting holes
    [throttle_box.scad]
2025-04-05 Add phantom rods
    [throttle_box.scad]
2025-04-05 Add rod holes
    [throttle_box.scad]
2025-04-05 Add rod nut holes
    [throttle_box.scad]
2025-04-05 Add screw columns
    [throttle_box.scad]
2025-04-05 Add CPU holder
    [throttle_box.scad]
2025-04-05 Cable hole
    [throttle_box.scad]
2025-04-05 Add cable clamp
    [throttle_box.scad]
2025-04-06 Fix spacings
    [throttle_box.scad]
2025-04-06 Makeing it smaller
    [throttle_box.scad]
2025-04-06 Add support support
    [throttle_box.scad]
2025-04-06 Add holes into seams
    [throttle_box.scad]
2025-04-08 Carb heat
    [carb_heat_knob.scad]
2025-04-08 Fix hole
    [carb_heat_knob.scad]
2025-04-08 Add patterns to top
    [carb_heat_knob.scad]
2025-04-08 Fix seam holes
    [throttle_box.scad]
2025-04-08 Fix pot widths
    [throttle_box.scad]
2025-04-08 Fix clamp depth
    [throttle_box.scad]
2025-04-08 Fix screw columns
    [throttle_box.scad]
2025-04-08 Fix small pot stand
    [throttle_box.scad]
2025-04-08 Fix big stand
    [throttle_box.scad]
2025-04-08 Fix CPU stand
    [throttle_box.scad]
2025-04-09 Add holder
    [throttle_box.scad]
2025-04-10 Fix big pot stands
    [throttle_box.scad]
2025-04-10 Add cradle top
    [throttle_box.scad]
2025-04-11 Cut carb heat button
    [carb_heat_knob.scad, throttle_box.scad]
2025-04-11 Add top
    [carb_heat_knob.scad]
2025-04-11 Add models
    [carb_heat_knob.scad]
2025-04-11 Fix to center piece
    [carb_heat_knob.scad]
2025-04-11 Add button
    [carb_heat_knob.scad]
2025-05-06 Add pin
    [pin.scad]
2025-05-06 Make u-pin
    [pin.scad]
2025-05-06 Add wide pin
    [pin.scad]
2025-05-07 Add reverse pin
    [pin.scad]
2025-05-07 Add clamp
    [clamp.scad]
2025-05-07 Update clamp
    [clamp.scad]
2025-05-07 Modify slider clamp
    [clamp.scad]
2026-11-06 Add throttle box lid
    [throttle_box.scad]
2026-11-06 Add switchpanel project with ignition key switch
    [ignition.scad]
2026-11-06 Render colored PNG views of the designs
    Add a "Make view <name> <rotation>" marker to the Makefile that renders a
    line to target/<file>_<name>.png, and exploded, assembled, inside and
    front views of the ignition switch. Failing renders now stop make.
    [ignition.scad]
2026-11-06 Add switch panel with master, light and avionics switches
    A separate panel for cheap KCD1 snap-in rockers: red split MASTER
    (ALT, BAT), seven single switches and white split AVIONICS (BUS 1,
    BUS 2), with engraved labels and PNG views. switches.md lists the
    hardware found on amazon.de.
    [switches.scad]
2026-11-06 Use double rockers and MTS-202 toggles on the switch panel
    MASTER and AVIONICS are 6 pin double rockers that snap into the panel,
    the middle switches MTS-202 mini toggles held by their nut and a body
    pocket. Add section views of both and update the hardware list.
    [switches.scad]
2026-11-06 Use M12 toggles on the switch panel, record the printer bed
    The middle switches are now standard size toggles (M12 neck, 18 mm
    lever), closer to the real ones; the mini MTS-202 stays selectable.
    Note the Kobra 3 V2 and its 255 x 255 mm bed in CLAUDE.md.
    [switches.scad]
2026-11-06 Add input multiplexer to the switch panel
    [switches.scad]
2026-11-06 Add README and publish renders to GitHub Pages
    Claude-Session: https://claude.ai/code/session_017MsWbk5VYcdZUrmdVMgXrB
    [switches.scad]
2026-11-07 Add throttle box views
    Claude-Session: https://claude.ai/code/session_017MsWbkgvWwYu4Qt6ZVRJuh
    [throttle_box.scad]
2026-11-07 Add dummy circuit breakers to the switch panel
    Claude-Session: https://claude.ai/code/session_017MsWbnn68AyqowAqCineYV
    [switches.scad]
2026-11-07 Print the throttle box underside in one piece
    Claude-Session: https://claude.ai/code/session_017MsWbmREV7RptetkkN2VWo
    [throttle_box.scad]
2026-11-07 Add ignition panel with shared panel dimensions
    Claude-Session: https://claude.ai/code/session_017MsWbnFJDWPqwWqiGacpcv
    [ignition.scad, panel.inc.scad, switches.scad]
2026-11-07 Add cockpit frame with panel sheet layout and throttle mount
    Claude-Session: https://claude.ai/code/session_017MsWbkeWv8hwtDwcatvqjB
    [frame.inc.scad, frame.scad]
2026-11-07 Add face flange to the switch panels for the cockpit sheet
    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
    [frame.inc.scad, frame.scad, ignition.scad, panel.inc.scad, switches.scad]
2026-11-07 Add face flange to the throttle box and drop its lid
    Claude-Session: https://claude.ai/code/session_017MsWbiguy2V61n7PcKocCr
    [frame.inc.scad, frame.scad, throttle_box.scad]
2026-11-07 Add under-desk aprons to the frame
    Claude-Session: https://claude.ai/code/session_017MsWbkQam1aN2drLLTSuPH
    [frame.inc.scad, frame.scad]
2026-11-07 Move the parking brake under the yoke and add clamp feet
    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
    [clamp_foot.scad, frame.inc.scad, frame.scad]
2026-11-09 Replace printed clamp feet with extrusion clamp arms
    Claude-Session: https://claude.ai/code/session_017MsWbnQXMBDg1623vH1C5F
    [clamp_foot.scad, frame.inc.scad, frame.scad]
2026-11-09 Clamp the frame with screw clamps on the front rail ends
    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
    [frame.inc.scad, frame.scad]
2026-11-09 Add the hub box and the Cat5 port standard
    Claude-Session: https://claude.ai/code/session_017MsWbkngnUTLKTYpYdGiru
    [hub.scad, switches.scad]
2026-11-09 Put the hub Nano on its own pedestal and add a prototype board
    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
    [hub.scad]
2026-11-09 Replace the hub breadboard with a bus on the prototype board
    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
    [hub.scad]
2026-11-09 Give the hub 12 ports in two rows with a soldered bus
    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
    [hub.scad, switches.scad]
2026-11-10 Switch from SimVim to MobiFlight
    Drop the servo Nano from the hub (MobiFlight drives servos from Mega
    pins), move the prototype board next to the Mega, give the trim encoder
    its own port and update the README and the port list.
    Claude-Session: https://claude.ai/code/session_017MsWbmDFAMe8WfPxfWU6Sg
    [hub.scad, ignition.scad]
2026-11-10 Solder the Cat5 cables to the components
    Drop the RJ45 board and Dupont header at the components: the cable is
    soldered to the mux, and the switch panel gets a cable tie block for
    strain relief. Document the cable choice in the README.
    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
    [hub.scad, switches.scad]
2026-11-10 Reduce the hub to one row of 6 ports
    Claude-Session: https://claude.ai/code/session_017MsWbkwcpKamAaapkmzUAq
    [hub.scad]
2026-11-10 Use a 5 mm cube magnet in the ignition rotor
    Claude-Session: https://claude.ai/code/session_017MsWbjzKWXWJAeYcyh18eF
    [ignition.scad]
2026-11-10 Add ignition label inlay for two-color printing
    Claude-Session: https://claude.ai/code/session_017MsWbnNMsb9WpCmZBWePJA
    [ignition.scad]
2026-11-10 Raise ignition panel labels for painting
    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
    [ignition.scad]
2026-11-10 Split ignition labels into a separate face
    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
    [ignition.scad]
2026-11-10 Split switch panel labels into a separate face
    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
    [ignition.scad, panel.inc.scad, switches.scad]
2026-11-10 Split frame into front and desk parts, all 2020
    Claude-Session: https://claude.ai/code/session_017MsWbmZBDqXp5T8S5sjLNn
    [frame.inc.scad, frame.scad, throttle_box.scad]
2026-11-10 Remove sideways throttle bar, bolt throttle box into front rail
    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
    [frame.inc.scad, frame.scad, throttle_box.scad]
2026-11-10 Use square-cut braces with 45 degree connectors, stock lengths
    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
    [frame.inc.scad, frame.scad]
2026-11-10 Lower the panel to what the parts need
    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
    [frame.inc.scad]
2026-11-10 Add flaps panel to the apron
    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
    [frame.inc.scad, frame.scad]
2026-11-11 Add direct hub ports for servos, encoders and pots
    Claude-Session: https://claude.ai/code/session_017MsWbmUZAQyPTUxnVzZHGc
    [hub.scad]
2026-11-11 Make the flaps panel DIY
    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
    [frame.inc.scad, frame.scad]
2026-11-11 Update ignition lock to measured values
    Claude-Session: https://claude.ai/code/session_017MsWbiQXyPQWCfFs9RPpfj
    [ignition.scad]
2026-11-11 Turn ignition lock so the key comes out at OFF
    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
    [ignition.scad]
2026-11-11 Note the ignition key comes out every 90 degrees
    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
    [ignition.scad]
2026-11-12 Widen cam screw hole in ignition rotor (#25)
    Claude-Session: https://claude.ai/code/session_017MsWbkghNzEJmUbKyoY94z
    [ignition.scad]
2026-11-12 Bigger spindle flat
    [ignition.scad]
2026-11-12 Widen cam screw hole in ignition rotor to 7 mm (#26)
    * Widen cam screw hole in ignition rotor
    * Widen cam screw hole in ignition rotor to 7 mm
    ---------
    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
    [ignition.scad]
2026-11-12 Add primer with twist lock above the switch panel (#27)
    * Pack the frame's right part tight, leave room on the left
    Claude-Session: https://claude.ai/code/session_017MsWbmL2heQ5mGFStnbmfX
    * Add primer with twist lock above the switch panel
    Claude-Session: https://claude.ai/code/session_017MsWbmL2heQ5mGFStnbmfX
    * Revert "Pack the frame's right part tight, leave room on the left"
    This reverts commit b7a4aca; the primer goes above the switch panel, so
    the left part does not need the room.
    Claude-Session: https://claude.ai/c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
    [frame.inc.scad, frame.scad, panel.inc.scad, primer.scad]
2026-11-12 Primer: measured pot travel, 45 mm stroke, pop out spring (#28)
    Claude-Session: https://cla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
    [frame.inc.scad, frame.scad, primer.scad]
2026-11-12 Add ignition back cap over the hall sensor legs (#29)
    Claude-Session: https://claude.ai/code/session_017MsWbk6yM9oP8TRgKQvMYJ
    [ignition.scad]
2026-11-14 Add sensor board holder to the ignition (#30)
    Claude-Session: https://claude.ai/code/session_017MsWbjU3713cHrEZG935gm
    [ignition.scad]
2026-11-14 Move the sensor board screw to the OUT column (#31)
    * Add sensor board holder to the ignition
    * Move the sensor board screw to the OUT column
    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
    [ignition.scad]
